HackerScouts/hackerling-circuit/docs/designing_notes.odt

Designing Hackerling circuit

Timers

There are several components that need timers:

Servos:

Servos work by sending a PWM (Pulse width modulated) signal. The period of this pulse is 50-60 Hz. The width of the pulse determines the position of the servo, on the range of: ~500us to 2000us. Assuming that the servo turns 180 degrees (although most just turn 90) and you want resolution of 1 degree, you will need resolution of ~8us.

http://www.servocity.com/html/180o_rotation_information.html

IR receiver, transmitter:

The IR receiver is tuned to a 38Khz carrier wave. According to the data sheet, the width of the data pulses should be at least 200us, and the output of the receiver has a pulse width of 400-1200us. We will have to slow the data rate to whatever the output rate of the receiver ends up being. This is an easy signal; as long as we configure the LEDs to pulse at 38Khz, we can check the input of the reciever each cycle, and also decide whether to set the “set” the data bit. A 600 us pulse is ~26 cycles of the 38Khz signal; we can send bit lengths from 8 to 40 cycles.

Speaker:

The speaker is a bit tricky. It involves looking up some info about sound.

We can hear sound from ~10Hz to ~5Khz. We perceive sound on a logarithmic scale, and sounds that are a factor of 2 apart sound very similar to us. For that reason, we group sounds within one order of 2 (for example from 220Hz to 440Hz) into what is known as an octave. We then subdivide each octave into smaller parts: the Chromatic scale defines the 12 notes we are usually familiar with (A,A#,B,C...etc) and the most commonly used pitch scale, A440 defines “the A above middle C” to have a frequency of 440Hz, and for each note to be spaced at an equal interval (on the logarithmic scale). Thus we can get all the frequencies of the notes by starting at 440 and multiplying by 2^(1/12). This gives us the following table:

Of course, since we are dealing with a logarithmic scale, which will give us irrational numbers and using subdivisions of a 16Mhz clock signal, we cannot hit all the notes exactly. So how close is good enough?

Well, according to this website, we cannot tell a difference of 5 cents, a cent being a 100th subdivision between adjacent notes, again equally subdivided on a logarithmic scale) so we only need to get w/in ~5 cents of the note.

The other problem with playing sound is that, since the scale changes so much, using one prescaler is not going to be very helpful; you will have a large amount of resolution in a few octaves, but very little in others. Even in 1 octave, some notes will be harder to achieve than others. The solution to this is to change the prescaler for different octaves. Usually atmel timers have a prescaler that changes by a power of 4, but on the atmega328, which we will be using, the timer2 has the following prescales:

1,8,32,64,128,256,1024 – 4 prescales being a power of two apart, perfect for octaves!

Here is a big table that shows the error of trying to play each note using different prescale values:

(http://en.wikipedia.org/wiki/Octave)

(http://en.wikipedia.org/wiki/Octave)

(http://en.wikipedia.org/wiki/Octave)

(http://en.wikipedia.org/wiki/Octave)

(http://en.wikipedia.org/wiki/Octave)

(http://en.wikipedia.org/wiki/Octave)

(http://en.wikipedia.org/wiki/Octave)

(http://en.wikipedia.org/wiki/Octave)

(http://en.wikipedia.org/wiki/Octave)

(http://en.wikipedia.org/wiki/Octave)

(http://en.wikipedia.org/wiki/Octave)

(http://en.wikipedia.org/wiki/Octave)

(http://en.wikipedia.org/wiki/Octave)

(http://en.wikipedia.org/wiki/Octave)

(http://en.wikipedia.org/wiki/Octave)

(http://en.wikipedia.org/wiki/Octave)

(http://en.wikipedia.org/wiki/Octave)

(http://en.wikipedia.org/wiki/Octave)

(http://en.wikipedia.org/wiki/Octave)

(http://en.wikipedia.org/wiki/Octave)

(http://en.wikipedia.org/wiki/Octave)

(http://en.wikipedia.org/wiki/Octave)

(http://en.wikipedia.org/wiki/Octave)

(http://en.wikipedia.org/wiki/Octave)

(http://en.wikipedia.org/wiki/Octave)

(http://en.wikipedia.org/wiki/Octave)

(http://en.wikipedia.org/wiki/Octave)

(http://en.wikipedia.org/wiki/Octave)

(http://en.wikipedia.org/wiki/Octave)

(http://en.wikipedia.org/wiki/Octave)

(http://en.wikipedia.org/wiki/Octave)

(http://en.wikipedia.org/wiki/Octave)

(http://en.wikipedia.org/wiki/Octave)

(http://en.wikipedia.org/wiki/Octave)

(http://en.wikipedia.org/wiki/Octave)

(http://en.wikipedia.org/wiki/Octave)

(http://en.wikipedia.org/wiki/Octave)

(http://en.wikipedia.org/wiki/Octave)

(http://en.wikipedia.org/wiki/Octave)

(http://en.wikipedia.org/wiki/Octave)

(http://en.wikipedia.org/wiki/Octave)

(http://en.wikipedia.org/wiki/Octave)

(http://en.wikipedia.org/wiki/Octave)

(http://en.wikipedia.org/wiki/Octave)

(http://en.wikipedia.org/wiki/Octave)

(http://en.wikipedia.org/wiki/Octave)

(http://en.wikipedia.org/wiki/Octave)

You notice that there is a distinct pattern that shows up – the prescales are logarithmic and so are the notes, so to computation comes out the same for when you increment the octave and double prescale value.

I grayed out certain parts of the table – those parts correspond to frequencies that are too low – meaning we would have to wait for a timer overflow, then increment a counter, and possibly change the compare interrupt at least once per period. This would be acceptable and allow greater accuracy if we were making something that only played sounds, but this is a multi-use device, and we want to have as little code executed by the main processor as possible. Therefore, we will not use the greyed areas.

Using the rest of the table, it is clear that you want to use as low a prescale as possible – lower prescales mean higher frequency, which means finer resolution. In the first octave the prescale can achieve, there is only one frequency that is over 5 cents off – G# (5.67 cents off), which isn't used much anyway. Down at 92Hz, you also have larger errors since the prescaler jumps by two, but this is pretty low, so we'll accept it.

(http://en.wikipedia.org/wiki/Octave)

http://en.wikipedia.org/wiki/Octave

http://en.wikipedia.org/wiki/A440_%28pitch_standard%29

http://www.aqdi.com/tuner.htm

We have 3 timers and 3 oscillating devices – perfect! (although certain functions of the arduino seem like they want to use a timer...)

Looking at pre-existing code, it seems like the servo is always run off of the

coding IR reciever

Found code at:

http://playground.arduino.cc/Code/InfraredReceivers for plotting outputs

plotted the output of the LED remote:

ON: 0x00 0xF7 0x20 0xDC (last two zeros not received though)

Red: 0x00 0xF7 0xC0 0x3C

Green:

Used this scrip, which gave the output:

tail -132 stream7 | awk 'BEGIN{last=0;s=0}{x=$1-last;b=0;if(x>1000) b=1;if(x>0 && $2==1)s*=2;if(x>0 && $2==1)s+=b; if(x>0 && $2==1)printf("%d %d %x\n",$1,x,s); last=$1}'

14492 476 0

15616 560 0

16712 480 0

17832 480 0

18956 564 0

20052 484 0

21172 480 0

22288 556 0

24508 1604 1

26728 1660 3

28972 1604 7

31184 1600 f

32308 564 1e

34520 1600 3d

36740 1660 7b

38980 1600 f7

41200 1604 1ef

42320 560 3de

44536 1604 7bd

45656 560 f7a

46752 480 1ef4

47880 488 3de8

48996 564 7bd0

50092 488 f7a0

51212 484 1ef40

53432 1664 3de81

54552 484 7bd02

56768 1660 f7a05

59008 1604 1ef40b

61224 1604 3de817

63444 1660 7bd02f

65688 1604

the time high is:

~1660 for 1

480 or 560 for 0

the low time is ~640

this time is in microseconds

so the output is 0xf7a05f

The frequency we are oscillating at is: 37914.691943128Hz which is 26.375 us

if our divisions are 1000us and 3500 us, this works out to:

1000us → 37.9 cycles → 38 cycles

3500us → 132.7 cycles → 133 cycles
