HackerScouts/hackerling-circuit/docs/Hackerling_Circuit_BOM.xls

Sheet: v1.3
Part number | qnty
k1 | 1 | 40 pin straight header | S1012EC-40-ND | CONN HEADER .100" SNGL STR 40POS | digikey
k2 | 2 | 330 Ohm resistor array | CSC330N-ND | RES ARRAY 330 OHM 7 RES 8-SIP | digikey
k3 | 1 | Green 5MM LED | 100QBK-ND | RES 100 OHM 1/4W 5% CARBON FILM | digikey
k4 | 1 | Speaker | 254-EMB15-RO | MINI TONE TRANSDUCER | Mouser
k5 | 1 | 100 Ohm Resistor | 100QBK-ND | RES 100 OHM 1/4W 5% CARBON FILM | digikey
k6 | 1 | B-12 Switch | 633-B12JH |  | Mouser
k7 | 1 | 8 pin io expander | MCP23008-E/P-ND | IC I/O EXPANDER I2C 8B 18DIP | digikey
k8 | 1 | 16 pin io expander | MCP23017-E/SP-ND | IC I/O EXPANDER I2C 16B 28SDIP | digikey
k9 | 1 | Bargraph LED Array | 604-DC10GWA |  | Mouser
k10 | 2 | 100 Ohm resistor array | 4608X-2-101LF-ND | RES ARRAY 100 OHM 4 RES 8SIP | digikey
k11 | 1 | Dip Switch | CT2094MS-ND | SWITCH RAISED ACTUATOR 4 SEC | digikey
k12 | 4 | 4x Buttons | SW413-ND | SWITCH TACTILE SPST-NO 0.05A 24V | digikey
k13 | 1 | Red cap | SW260-ND | KEYCAP 12MM SQ RED FITS 12MM | digikey
k14 | 1 | Orange cap | SW956-ND | KEYCAP 12MM SQ ORANGE FITS | digikey
k15 | 1 | Green Cap | SW957-ND | KEYCAP 12MM GRN FITS 12MM | digikey
k16 | 1 | Blue Cap | SW258-ND | KEYCAP 12MM SQ BLUE FITS 12MM | digikey
k17 | 1 | 47 Ohm resistor | 47QBK-ND | RES 47 OHM 1/4W 5% CARBON FILM | digikey
k18 | 1 | 10 uF cap | 445-2863-ND | CAP CER 10UF 6.3V 10% RADIAL | digikey
k19 | 1 | IR photo detector | 425-2501-ND | RECEIVER IR REM CTRL 5V 38KHZ | digikey
k20 | 2 | IR LED | 475-1200-ND | EMITTER IR 850NM 5MM RADIAL | digikey
k21 | 1 | 6 pin right angle header | S1112EC-40-ND | CONN HEADER .100" SNGL R/A 40POS | digikey
k22 | 1 | 502kOhm resistor | 412KXBK-ND | RES 412K OHM 1/4W 1% METAL FILM | digikey
k23 | 1 | 100 Kohm thermistor | BC2424-ND | THERMISTOR NTC 330K 5% RADIAL | digikey
k24 | 1 | 10k pot | PTV09A-4225F-B103-ND | POT 10K OHM 9MM SQ .05W CARB | digikey
k25 | 1 | Pot cap | 450-2034-GRX | KNOB FOR 1/4" SHAFT | Mouser
k26 | 1 | 100 Ohm Pot | 3306K-103-ND | TRIMMER 10K OHM 0.2W PC PIN | digikey
k27 | 1 | 16x2 char LCD | 668-NC-S16205DFYSAY |  | Mouser
a1 | 1 | Accelerometer | 841-MMA8452QR1 | IC ACCELEROMETER 3AXIS 16QFN | Mouser
a2 | 2 | 470 ohm resistor | RMCF0603JT470RCT-ND | RES 470 OHM 1/10W 5% 0603 | digikey
a3 | 1 | 200K resistor | 311-200KGRCT-ND | RES 200K OHM 1/10W 5% 0603 SMD | digikey
a4 | 1 | I2c Level shifter | 296-17988-1-ND | IC VOLT LEVEL TRANSLATOR 8-VSSOP | digikey
a5 | 1 | 4.7 uF Cap | 399-3482-1-ND | CAP CER 4.7UF 6.3V 10% X5R 0603 | digikey
a6 | 2 | 4k7 resistor | CR0603-JW-472ELFCT-ND | RES 4.7K OHM 1/10W 5% 0603 SMD | digikey
a7 | 1 | .1 uF Cap | 311-1341-1-ND | CAP CER 0.1UF 25V 10% X7R 0603 | digikey
a8 | 1 | 1 uF cap | 311-1372-1-ND | CAP CER 1UF 16V Y5V 0603 | digikey
a9 | 1 | 3.3V power supply | TC1016-3.3VCTCT-ND | IC REG LDO 3.3V 80MA SOT23-5 | digikey

Sheet: v1.2
Index | Quantity | Part Number | Description |  | Customer Reference | Quantity needed | Unit Price USD
1 | 30 | CT2094MS-ND | SWITCH RAISED ACTUATOR 4 SEC |  | SW1 | 1 | 0.683 | 0.683
2 | 30 | 445-2863-ND | CAP CER 10UF 6.3V 10% RADIAL | FOR IR RECIEVER | C4 | 1 | 0.328 | 0.328
3 | 25 | 425-2501-ND | RECEIVER IR REM CTRL 5V 38KHZ | FOR IR RECIEVER | IR1 | 1 | 0.768 | 0.768
4 | 30 | 3306K-103-ND | TRIMMER 10K OHM 0.2W PC PIN |  | U8 | 1 | 0.3456 | 0.3456
5 | 30 | 311-1355-1-ND | CAP CER 10UF 10V Y5V 0805 | Optional (to be removed) | C5 | 1 | 0.0824 | 0.0824
6 | 100 | 47QBK-ND | RES 47 OHM 1/4W 5% CARBON FILM | FOR IR RECIEVER | R6 | 1 | 0.0242 | 0.0242
7 | 100 | 311-47ARCT-ND | RES 47 OHM 1/8W 5% 0805 SMD | Optional (to be removed) | R7 | 1 | 0.0077 | 0.0077
8 | 120 | SW413-ND | SWITCH TACTILE SPST-NO 0.05A 24V |  | B1,B2,B3,B4 | 4 | 0.4253 | 1.7012
9 | 100 | 311-1372-1-ND | CAP CER 1UF 16V Y5V 0603 |  | C1 | 1 | 0.0186 | 0.0186
10 | 50 | 399-3482-1-ND | CAP CER 4.7UF 6.3V 10% X5R 0603 |  | C3 | 1 | 0.0518 | 0.0518
11 | 25 | MCP23008-E/P-ND | IC I/O EXPANDER I2C 8B 18DIP |  | IC2 | 1 | 0.85 | 0.85
12 | 100 | 475-1200-ND | EMITTER IR 850NM 5MM RADIAL |  | LED1,LED2,LED3 | 3 | 0.3879 | 1.1637
13 | 60 | CSC330N-ND | RES ARRAY 330 OHM 7 RES 8-SIP |  | RN3,RN4 | 2 | 0.231 | 0.462
14 | 30 | MMA8452QT-ND | IC ACCELEROMETER 3AXIS 16QFN |  | U1 | 1.5 | 1.168 | 1.752
15 | 100 | 296-17988-1-ND | IC VOLT LEVEL TRANSLATOR 8-VSSOP |  | U5 | 1 | 0.3159 | 0.3159
16 | 20 | S1012EC-40-ND | CONN HEADER .100" SNGL STR 40POS |  | STRAIGHT HEADERS | 2 | 0.459 | 0.918
17 | 5 | S1112EC-40-ND | CONN HEADER .100" SNGL R/A 40POS |  | RIGHT ANGLE HEADER | 0.1 | 0.64 | 0.064
18 | 30 | BC2424-ND | THERMISTOR NTC 330K 5% RADIAL |  | R1 | 1 | 0.264 | 0.264
19 | 100 | 412KXBK-ND | RES 412K OHM 1/4W 1% METAL FILM |  | R2 | 1 | 0.0315 | 0.0315
20 | 1 | EG2448-ND | SWITCH TOGGLE SPDT .4VA RT ANG |  | SW2 ALT | 1 | 3.22 | 3.22
21 | 30 | TC1016-3.3VCTCT-ND | IC REG LDO 3.3V 80MA SOT23-5 |  | IC3 | 1 | 0.3 | 0.3
 |  |  |  |  |  |  |  | 0
20 |  | LCD-226 | LCD screen |  |  | 1 | 6.00 | 6 | allelectronics
20 |  | BG-10G | bargraph |  |  | 1 | 1.25 | 1.25 | allelectronics
20 |  | KNB-124 | knob for pot |  |  | 1 | 0.65 | 0.65 | allelectronics
20 |  | PE-52 | buzzer |  |  | 1 | 0.50 | 0.5 | allelectronics
 |  |  | Board |  |  | 1 | 10 | 10
 |  | 652-PTV09A-4225FB102 |  |  |  | 1 | 0.62 | 0.62
 |  | 633-B12JH |  |  |  | 1 | 3.46 | 3.46
 |  | 579-MCP23017-E/SP |  |  |  | 1 | 1 | 1
 |  |  | arduino uno |  |  |  |  | 26.95
 |  |  |  |  |  |  |  | 63.7816

Sheet: v1.1
board part ID | My part ID | description | value | size | qnty used | price |  | Use notes | Retail ID | Retailor | Manufacturer's id
 | MTS-86RT | DPDT ON-ON MINI-TOGGLE SWITCH |  |  |  | 1.25 |  | maybe too big? | MTS-86RT | AllElectronics
R1 | TNR-103 | 10K OHM NTC THERMISTOR |  |  | 1 | 0.65 |  |  | TNR-103 | AllElectronics
 | PE-52 | MINI TONE TRANSDUCER |  |  |  | 0.5 |  |  | PE-52 | AllElectronics
SG1 | PE-38 | MINI TONE TRANSDUCER |  | 0.82" DIA. X 0.15" | 1 | 0.334 |  |  | PE-38 | AllElectronics
 | PB-214 | JUMBO PUSHBUTTON, GREEN |  |  | 0 | 3.75 |  |  | PB-214 | AllElectronics
U2 | LCD-226 | 16 X 2 LCD W/ LED BACKLIGHT |  |  |  | 6 |  |  | LCD-226 | AllElectronics
 | LCD-2161 | 16 X 1 LCD W/ LED BACKLIGHT |  |  |  | 3 |  |  | LCD-2161 | AllElectronics
 | LCD-8002 | 8 CHARACTER X 2 LINE LCD |  |  |  | 3.25 |  |  | LCD-8002 | AllElectronics
 | BG-10G | 10 SEGMENT BARGRAPH, GREEN |  |  |  | 1.5 |  |  | BG-10G | AllElectronics
 | KNB-124 | KNOB FOR 1/4" SHAFT |  |  |  | 0.75 |  |  | KNB-124 | AllElectronics
 | LPC-10K | 10K LIN. POT W/CTR DETENT, PC MT |  |  |  | 0.25 |  |  | LPC-10K | AllElectronics
 | DWS-4S | 4-POLE DIP SWITCH, LOW PROFILE |  |  |  | 1 | digikey | CT2094MS-ND | DWS-4S | AllElectronics
 | CSC330N-ND | RES ARRAY 330 OHM 7 RES 8-SIP |  |  | 2 | 0.49 |  |  | CSC330N-ND | Digikey |  | RN1, RN2 | $1.96
 | 296-17988-1-ND | IC VOLT LEVEL TRANSLATOR 8-VSSOP |  |  | 1 | 0.96 |  |  | 296-17988-1-ND | Digikey |  | I2C TRANSLATOR | $3.84
 | MMA8452QT-ND | IC ACCELEROMETER 3AXIS 16QFN |  |  | 1 | 1.31 |  |  | MMA8452QT-ND | Digikey |  | ACCELEROMETER | $5.24
 | TC1016-3.0VCTCT-ND | IC REG LDO 3V 80MA SOT23-5 |  |  | 0 | 0.43 |  |  | TC1016-3.0VCTCT-ND | Digikey |  | 3.3V REG | $1.72
 | 1219-1083-1-ND | IC REG LDO 3V SOT23-5 |  |  | 1 | 0.4 |  |  | 1219-1083-1-ND | Digikey |  | 3V REG | $1.60
 | MCP23008-E/P-ND | IC I/O EXPANDER I2C 8B 18DIP |  |  | 1 | 1.22 |  |  | MCP23008-E/P-ND | Digikey |  |  | $4.88
 | 1050-1024-ND | ARDUINO UNO BOARD REV3 |  |  | 1 | 26.39 |  |  | 1050-1024-ND | Digikey |  |  | $52.78
 | MCP23017-E/SP-ND | IC I/O EXPANDER I2C 16B 28SDIP |  |  | 1 | 1.44 |  |  | MCP23017-E/SP-ND | Digikey |  |  | $5.76
 | SW414-ND | SWITCH TACTILE SPST-NO 0.05A 24V |  |  | 4 | 0.5124 |  |  | SW414-ND | Digikey |  |  | $12.81
 | SW957-ND | KEYCAP 12MM GRN FITS 12MM |  |  | 1 | 0.279 |  |  | SW957-ND | Digikey |  |  | $2.79
 | SW956-ND | KEYCAP 12MM SQ ORANGE FITS |  |  | 1 | 0.279 |  |  | SW956-ND | Digikey |  |  | $2.79
 | SW260-ND | KEYCAP 12MM SQ RED FITS 12MM |  |  | 1 | 0.279 |  |  | SW260-ND | Digikey |  |  | $2.79
 | SW258-ND | KEYCAP 12MM SQ BLUE FITS 12MM |  |  | 1 | 0.279 |  |  | SW258-ND | Digikey |  |  | $2.79
 | 475-1200-ND | EMITTER IR 850NM 5MM RADIAL |  |  |  | 0.428 |  |  | 475-1200-ND | Digikey |  |  | $4.28
 | EG4912-ND | SWITCH TOGGLE SPDT .4VA R/A |  |  | 1 | 2.99 |  |  | EG4912-ND | Digikey |  |  | $5.98
 | B13EH-ND | SW TOGGLE SPDT .4VA RA BRKT ESD |  |  | 0 | 4.2 |  |  | B13EH-ND | Digikey |  |  | $8.40
 | 425-2501-ND | RECEIVER IR REM CTRL 5V 38KHZ |  |  | 1 | 0.96 |  |  | 425-2501-ND | Digikey |  |  | $3.84
 | 311-1372-1-ND | CAP CER 1UF 16V Y5V 0603 |  |  |  | 0.041 |  |  | 311-1372-1-ND | Digikey |  |  | $0.41
 | 399-3482-1-ND | CAP CER 4.7UF 6.3V 10% X5R 0603 |  |  |  | 0.09 |  |  | 399-3482-1-ND | Digikey |  |  | $0.90
 | 311-200KGRCT-ND | RES 200K OHM 1/10W 5% 0603 SMD |  |  | 1 | 0.0048 |  |  | 311-200KGRCT-ND | Digikey |  |  | $0.48
R3,R4 | CR0603-JW-472ELFCT-ND | RES 4.7K OHM 1/10W 5% 0603 SMD |  |  |  | 0.0044 |  |  | CR0603-JW-472ELFCT-ND | Digikey |  |  | $0.44
 | 311-1341-1-ND | CAP CER 0.1UF 25V 10% X7R 0603 |  |  |  | 0.01 |  |  | 311-1341-1-ND | Digikey |  |  | $1.00
 |  |  |  |  |  | 65.2306

Sheet: Sheet2
therm | 1 | 2 | 3 | 4 | 5 | 6 | 7 | 8 | 9 | 10 | 11 | 12 | 13 | 14 | 15 | 16 | 17 | 18 | 19 | 20 | 21 | 22
1 | 0.500 | 0.667 | 0.750 | 0.800 | 0.833 | 0.857 | 0.875 | 0.889 | 0.900 | 0.909 | 0.917 | 0.923 | 0.929 | 0.933 | 0.938 | 0.941 | 0.944 | 0.947 | 0.950 | 0.952 | 0.955 | 0.957
2 | 0.333 | 0.500 | 0.600 | 0.667 | 0.714 | 0.750 | 0.778 | 0.800 | 0.818 | 0.833 | 0.846 | 0.857 | 0.867 | 0.875 | 0.882 | 0.889 | 0.895 | 0.900 | 0.905 | 0.909 | 0.913 | 0.917
3 | 0.250 | 0.400 | 0.500 | 0.571 | 0.625 | 0.667 | 0.700 | 0.727 | 0.750 | 0.769 | 0.786 | 0.800 | 0.812 | 0.824 | 0.833 | 0.842 | 0.850 | 0.857 | 0.864 | 0.870 | 0.875 | 0.880
4 | 0.200 | 0.333 | 0.429 | 0.500 | 0.556 | 0.600 | 0.636 | 0.667 | 0.692 | 0.714 | 0.733 | 0.750 | 0.765 | 0.778 | 0.789 | 0.800 | 0.810 | 0.818 | 0.826 | 0.833 | 0.840 | 0.846
5 | 0.167 | 0.286 | 0.375 | 0.444 | 0.500 | 0.545 | 0.583 | 0.615 | 0.643 | 0.667 | 0.688 | 0.706 | 0.722 | 0.737 | 0.750 | 0.762 | 0.773 | 0.783 | 0.792 | 0.800 | 0.808 | 0.815
6 | 0.143 | 0.250 | 0.333 | 0.400 | 0.455 | 0.500 | 0.538 | 0.571 | 0.600 | 0.625 | 0.647 | 0.667 | 0.684 | 0.700 | 0.714 | 0.727 | 0.739 | 0.750 | 0.760 | 0.769 | 0.778 | 0.786
7 | 0.125 | 0.222 | 0.300 | 0.364 | 0.417 | 0.462 | 0.500 | 0.533 | 0.562 | 0.588 | 0.611 | 0.632 | 0.650 | 0.667 | 0.682 | 0.696 | 0.708 | 0.720 | 0.731 | 0.741 | 0.750 | 0.759
8 | 0.111 | 0.200 | 0.273 | 0.333 | 0.385 | 0.429 | 0.467 | 0.500 | 0.529 | 0.556 | 0.579 | 0.600 | 0.619 | 0.636 | 0.652 | 0.667 | 0.680 | 0.692 | 0.704 | 0.714 | 0.724 | 0.733
9 | 0.100 | 0.182 | 0.250 | 0.308 | 0.357 | 0.400 | 0.438 | 0.471 | 0.500 | 0.526 | 0.550 | 0.571 | 0.591 | 0.609 | 0.625 | 0.640 | 0.654 | 0.667 | 0.679 | 0.690 | 0.700 | 0.710
10 | 0.091 | 0.167 | 0.231 | 0.286 | 0.333 | 0.375 | 0.412 | 0.444 | 0.474 | 0.500 | 0.524 | 0.545 | 0.565 | 0.583 | 0.600 | 0.615 | 0.630 | 0.643 | 0.655 | 0.667 | 0.677 | 0.688
 | 0.2424242424 | 0.3333333333 | 0.3692307692 | 0.380952381 | 0.380952381 | 0.375 | 0.3660130719 | 0.3555555556 | 0.3444976077 | 0.3333333333 | 0.3223443223 | 0.3116883117 | 0.3014492754 | 0.2916666667 | 0.2823529412 | 0.2735042735 | 0.2651072125 | 0.2571428571 | 0.249589491 | 0.2424242424 | 0.2356241234 | 0.2291666667
 | 0.05194805195 | 0.08333333333 | 0.1025641026 | 0.1142857143 | 0.1212121212 | 0.125 | 0.1266968326 | 0.126984127 | 0.1263157895 | 0.125 | 0.1232492997 | 0.1212121212 | 0.118993135 | 0.1166666667 | 0.1142857143 | 0.1118881119 | 0.1095008052 | 0.1071428571 | 0.1048275862 | 0.1025641026 | 0.1003584229 | 0.09821428571

Sheet: Sheet3
board part ID | My part ID | description | value | size | qnty used | qnty have | price | Use notes | Retail ID | Retailor | Manufacturer's id
 | MTS-86RT | DPDT ON-ON MINI-TOGGLE SWITCH |  |  |  | 2 | 1.25 | maybe too big? | MTS-86RT | AllElectronics
R1 | TNR-103 | 10K OHM NTC THERMISTOR |  |  | 1 | 3 | 0.65 |  | TNR-103 | AllElectronics
SG1 | PE-38 | MINI TONE TRANSDUCER |  | 0.82" DIA. X 0.15" | 1 | 3 | 0.334 |  | PE-38 | AllElectronics
 | PB-214 | JUMBO PUSHBUTTON, GREEN |  |  | 0 | 1 | 3.75 |  | PB-214 | AllElectronics
 | LCD-2161 | 16 X 1 LCD W/ LED BACKLIGHT |  |  |  | 2 | 3 |  | LCD-2161 | AllElectronics
 | LCD-8002 | 8 CHARACTER X 2 LINE LCD |  |  |  | 2 | 3.25 |  | LCD-8002 | AllElectronics
 |  |  |  |  |  |  |  |  |  |  |  | I2C TRANSLATOR | $3.84
 | TC1016-3.0VCTCT-ND | IC REG LDO 3V 80MA SOT23-5 |  |  | 0 | 4 | 0.43 |  | TC1016-3.0VCTCT-ND | Digikey |  | 3.3V REG | $1.72
 | 1219-1083-1-ND | IC REG LDO 3V SOT23-5 |  |  | 1 | 4 | 0.4 |  | 1219-1083-1-ND | Digikey |  | 3V REG | $1.60
 | EG4912-ND | SWITCH TOGGLE SPDT .4VA R/A |  |  | 1 | 2 | 2.99 |  | EG4912-ND | Digikey |  |  | $5.98
 | B13EH-ND | SW TOGGLE SPDT .4VA RA BRKT ESD |  |  | 0 | 2 | 4.2 |  | B13EH-ND | Digikey |  |  | $8.40
 | SW957-ND | KEYCAP 12MM GRN FITS 12MM |  |  | 1 | 10 | 0.279 |  | SW957-ND | Digikey |  |  | $2.79
 | SW956-ND | KEYCAP 12MM SQ ORANGE FITS |  |  | 1 | 10 | 0.279 |  | SW956-ND | Digikey |  |  | $2.79
 | SW260-ND | KEYCAP 12MM SQ RED FITS 12MM |  |  | 1 | 10 | 0.279 |  | SW260-ND | Digikey |  |  | $2.79
 | SW258-ND | KEYCAP 12MM SQ BLUE FITS 12MM |  |  | 1 | 10 | 0.279 |  | SW258-ND | Digikey |  |  | $2.79

Sheet: Sheet4
 |  |  |  |  | qnty | ordered
B1 |  | SWITCH_BCF-4000 | SWITCH_B3F-4000 | hackerscouts | 120 | 2013-01-02 | SW414-ND | SWITCH TACTILE SPST-NO 0.05A 24V |  |  |  | 0.5124 |  |  | SW414-ND | Digikey
B2 |  | SWITCH_BCF-4000 | SWITCH_B3F-4000 | hackerscouts | 120 | 2013-01-02 | SW414-ND | SWITCH TACTILE SPST-NO 0.05A 24V |  |  |  | 0.5124 |  |  | SW414-ND | Digikey
B3 |  | SWITCH_BCF-4000 | SWITCH_B3F-4000 | hackerscouts | 120 | 2013-01-02 | SW414-ND | SWITCH TACTILE SPST-NO 0.05A 24V |  |  |  | 0.5124 |  |  | SW414-ND | Digikey
B4 |  | SWITCH_BCF-4000 | SWITCH_B3F-4000 | hackerscouts | 120 | 2013-01-02 | SW414-ND | SWITCH TACTILE SPST-NO 0.05A 24V |  |  |  | 0.5124 |  |  | SW414-ND | Digikey
C1 | 1uF | C-USC0603K | C0603K | resistor | 100 | 2013-01-02 | 311-1372-1-ND | CAP CER 1UF 16V Y5V 0603 |  |  | 10 | 0.041 |  |  | 311-1372-1-ND | Digikey
C2 | 0.1uF | C-USC0603K | C0603K | resistor | 100 | 2012-11-30 | 311-1341-1-ND | CAP CER 0.1UF 25V 10% X7R 0603 |  |  | 100 | 0.01 |  |  | 311-1341-1-ND | Digikey
C3 | 4.7uF | C-USC0603K | C0603K | resistor | 50 | 2013-01-02 | 399-3482-1-ND | CAP CER 4.7UF 6.3V 10% X5R 0603 |  |  | 10 | 0.09 |  |  | 399-3482-1-ND | Digikey
C4 | 10uF | C-US050-050X075 | C050-050X075 | rcl | 30 | 2013-01-02 | 445-2863-ND (http://www.digikey.com/scripts/DKSearch/dksus.dll?Detail&itemSeq=123546165&uq=634926983742302205) | CAP CER 10UF 6.3V 10% RADIAL
C5 | 10uF | C-USC0805K | C0805K | resistor | 30 | 2013-01-02 | 311-1355-1-ND (http://www.digikey.com/scripts/DKSearch/dksus.dll?Detail&itemSeq=124219124&uq=634926995471126111) | CAP CER 10UF 10V Y5V 0805
DZ1 | LB10 | LB10 | LB10 | led | 20 | 2012-12-06 | BG-10G | 10 SEGMENT BARGRAPH, GREEN |  |  | 4 | 1.5 |  |  | BG-10G
IC1 | MCP23017SP | MCP23017SP | DIL28-3 | adafruit | 30 | 2013-01-02 | MCP23017-E/SP-ND | IC I/O EXPANDER I2C 16B 28SDIP | mouser | 1 | 4 | 1.44 |  |  | MCP23017-E/SP-ND | Digikey
IC2 | MCP2300X/P | MCP2300X/P | DIL18 | adafruit | 25 | 2013-01-02 | MCP23008-E/P-ND | IC I/O EXPANDER I2C 8B 18DIP |  | 1 | 4 | 1.22 |  |  | MCP23008-E/P-ND | Digikey
IC3 | MIC5219BM5 | MIC5219BM5 | SOT23-5 | v-reg-micrel | 30 | 2013-01-02 | TC1016-3.3VCTCT-ND (http://www.digikey.com/scripts/DKSearch/dksus.dll?Detail&itemSeq=124254332&uq=634927446236049921) | IC REG LDO 3.3V 80MA SOT23-5
IR1 | PNA460XM | PNA460XM | PNA460XM | adafruit | 25 | 2013-01-02 | 425-2501-ND | RECEIVER IR REM CTRL 5V 38KHZ |  | 1 | 4 | 0.96 |  |  | 425-2501-ND | Digikey
JP1 |  | M02LOCK | 1X02_LOCK | SparkFun |  | 2013-01-02 | S1012EC-40-ND (http://www.digikey.com/scripts/DKSearch/dksus.dll?Detail&itemSeq=124244704&uq=634927353556944550) | straight header 2x
JP2 |  | M02LOCK | 1X02_LOCK | SparkFun |  | 2013-01-02 | S1012EC-40-ND (http://www.digikey.com/scripts/DKSearch/dksus.dll?Detail&itemSeq=124244704&uq=634927353556944550) | straight header 2x
LED1 |  | LED5MM | LED5MM | SparkFun | 100 | 2013-01-02 | 475-1200-ND | EMITTER IR 850NM 5MM RADIAL |  |  | 10 | 0.428 |  |  | 475-1200-ND | Digikey
LED2 |  | LED5MM | LED5MM | SparkFun | 100 | 2013-01-02 | 475-1200-ND | EMITTER IR 850NM 5MM RADIAL |  |  | 10 | 0.428 |  |  | 475-1200-ND | Digikey
LED3 |  | LED5MM | LED5MM | SparkFun | 100 | 2013-01-02 | 475-1200-ND | EMITTER IR 850NM 5MM RADIAL |  |  | 10 | 0.428 |  |  | 475-1200-ND | Digikey
R1 | THERMISTOR-5 | THERMISTOR-5 | R-5 | varistor | 30 | 2013-01-02 | BC2424-ND (http://www.digikey.com/scripts/DKSearch/dksus.dll?Detail&itemSeq=124251169&uq=634927409292604193) | THERMISTOR NTC 330K 5% RADIAL
R2 |  | R-EU_0204/7 | 0204/7 | resistor | 100 | 2013-01-02 | 412KXBK-ND (http://www.digikey.com/scripts/DKSearch/dksus.dll?Detail&itemSeq=124251684&uq=634927409292604193) | RES 412K OHM 1/4W 1% METAL FILM
R3 | 4k7 | RESISTOR0603-RES | 0603-RES | SparkFun | 100 | 2012-11-30 | CR0603-JW-472ELFCT-ND | RES 4.7K OHM 1/10W 5% 0603 SMD |  |  | 100 | 0.0044 |  |  | CR0603-JW-472ELFCT-ND | Digikey
R4 | 4k7 | RESISTOR0603-RES | 0603-RES | SparkFun | 100 | 2012-11-30 | CR0603-JW-472ELFCT-ND | RES 4.7K OHM 1/10W 5% 0603 SMD |  |  | 100 | 0.0044 |  |  | CR0603-JW-472ELFCT-ND | Digikey
R5 | 200K | RESISTOR0603-RES | 0603-RES | SparkFun | 100 | 2012-11-30 | 311-200KGRCT-ND | RES 200K OHM 1/10W 5% 0603 SMD |  | 1 | 100 | 0.0048 |  |  | 311-200KGRCT-ND | Digikey
R6 | 47 | R-US_0204/7 | 0204/7 | resistor | 100 | 2013-01-02 | 47QBK-ND (http://www.digikey.com/scripts/DKSearch/dksus.dll?Detail&itemSeq=124219190&uq=634926999547019698) | RES 47 OHM 1/4W 5% CARBON FILM
R7 | 47 | R-US_R0805 | R0805 | rcl | 100 | 2013-01-02 | 311-47ARCT-ND (http://www.digikey.com/scripts/DKSearch/dksus.dll?Detail&itemSeq=124219219&uq=634926999547019698) | RES 47 OHM 1/8W 5% 0805 SMD
RN3 |  | G07R | SIL8 | resistor-sil | 60 | 2013-01-02 | CSC330N-ND | RES ARRAY 330 OHM 7 RES 8-SIP |  | 2 | 4 | 0.49 |  |  | CSC330N-ND | Digikey
RN4 |  | G07R | SIL8 | resistor-sil | 60 | 2013-01-02 | CSC330N-ND | RES ARRAY 330 OHM 7 RES 8-SIP |  | 2 | 4 | 0.49 |  |  | CSC330N-ND | Digikey
SERVO1 |  | M03LOCK | 1X03_LOCK | SparkFun |  | 2013-01-02 | S1112EC-40-ND (http://www.digikey.com/scripts/DKSearch/dksus.dll?Detail&itemSeq=124245388&uq=634927353556944550) | right angle
SERVO2 |  | M03LOCK | 1X03_LOCK | SparkFun |  | 2013-01-02 | S1112EC-40-ND (http://www.digikey.com/scripts/DKSearch/dksus.dll?Detail&itemSeq=124245388&uq=634927353556944550) | right angle
SG1 | BUZZERNS | BUZZERNS | BUZZER-12MM-NS | SparkFun | 20 | 2012-12-06 | PE-52 | MINI TONE TRANSDUCER |  |  | 4 | 0.5 |  |  | PE-52 | AllElectronics
SW1 |  | SW_DIP-4 | EDG-04 | special | 30 | 2013-01-02 | DWS-4S | 4-POLE DIP SWITCH, LOW PROFILE |  |  | 3 | 1 | digikey | CT2094MS-ND | DWS-4S | AllElectronics | CT2094MS-ND (http://www.digikey.com/scripts/DKSearch/dksus.dll?Detail&itemSeq=123452126&uq=634926983742302205) | SWITCH RAISED ACTUATOR 4 SEC
SW2 | SWITCH_B13EH | SWITCH_B13EH | SWITCH_B13EH | hackerscouts | 25 | 2013-01-02 | B12JH | mouser
U4 | ACCELEROMETER | ACCELEROMETER | ACCELEROMETER | hackerscouts |  | 2013-01-02 | S1012EC-40-ND (http://www.digikey.com/scripts/DKSearch/dksus.dll?Detail&itemSeq=124244704&uq=634927353556944550) | straight header 6x
U6 | ACCELEROMETER | ACCELEROMETER | ACCELEROMETER | hackerscouts |  | 2013-01-02 |  | duplicate...
U8 | SML_POT | SML_POT | SML_POT | hackerscouts | 30 | 2013-01-02 | 3306K-103-ND (http://www.digikey.com/scripts/DKSearch/dksus.dll?Detail&itemSeq=124219018&uq=634926999547019698) | TRIMMER 10K OHM 0.2W PC PIN
U1 | MMA8452Q | MMA8452Q | QFN-16(5X3) | hackerscouts | 30 | 2013-01-02 | MMA8452QT-ND | IC ACCELEROMETER 3AXIS 16QFN |  | 1 | 4 | 1.31 |  |  | MMA8452QT-ND | Digikey
U2 | LCD_16X2 | LCD_16X2 | LCD_16X2 | hackerscouts | 20 | 2012-12-06 | LCD-226 | 16 X 2 LCD W/ LED BACKLIGHT |  |  | 1 | 6 |  |  | LCD-226 | AllElectronics
U3 | ARDUINOR3-BPLACE | ARDUINOR3-BPLACE | ARDUINOR3-BPLACE | adafruit |  | 2013-01-02 | S1012EC-40-ND (http://www.digikey.com/scripts/DKSearch/dksus.dll?Detail&itemSeq=124244704&uq=634927353556944550) | straight header 10,8,6,5x → 29x
U5 | PCA9306 | PCA9306 | VSSOP-8 | hackerscouts | 100 | 2013-01-02 | 296-17988-1-ND | IC VOLT LEVEL TRANSLATOR 8-VSSOP |  | 1 | 4 | 0.96 |  |  | 296-17988-1-ND | Digikey
U7 | POT | POT | ALS_POT | hackerscouts | 20 | 2012-12-06 | LPC-10K | 10K LIN. POT W/CTR DETENT, PC MT |  |  | 4 | 0.25 |  |  | LPC-10K | AllElectronics
 |  |  |  |  |  |  | 652-PTV09A-4225FB102 (http://www.mouser.com/Search/ProductDetail.aspx)
 |  |  |  |  | 20 | 2012-12-06 | KNB-124 | KNOB FOR 1/4" SHAFT |  |  | 1 | 0.75 |  |  | KNB-124 | AllElectronics
 |  |  |  |  | 20 | 2012-12-15 | 1050-1024-ND | ARDUINO UNO BOARD REV3 |  | 1 | 2 | 26.39 |  |  | 1050-1024-ND | Digikey

Sheet: Sheet5
 |  | Header prices
 |  |  | Price per part |  |  | price per pin
 | part | #pins | @10 | @25 | @100 | @10 | @25 | @100
 | S1012EC-40-ND | 40 | 0.459 | 0.459 | 0.378 | 0.011475 | 0.011475 | 0.009450
 | 952-2267-ND | 5 | 0.275 | 0.1952 | 0.1375 | 0.055000 | 0.039040 | 0.027500
 | 952-1843-ND | 10 | 0.383 | 0.286 | 0.22 | 0.038300 | 0.028600 | 0.022000
 | 952-1901-ND | 20 | 0.63 | 0.54 | 0.423 | 0.031500 | 0.027000 | 0.021150
 | A26509-40-ND | 40 | 1.703 | 1.703 | 1.402 | 0.042575 | 0.042575 | 0.035050
 | SAM1035-50-ND | 50 | 1.951 | 1.951 | 1.6065 | 0.039020 | 0.039020 | 0.032130
right angle | S1112EC-40-ND | 40 | 0.569 | 0.569 | 0.468 | 0.014225 | 0.014225 | 0.011700 |  |  |  |  |  |  | 13
 | 609-3408-ND | 20 | 0.946 | 0.8904 | 0.8162 | 0.047300 | 0.044520 | 0.040810 |  |  |  |  |  |  | 2.564949357
 |  |  |  |  |  | #DIV/0! | #DIV/0! | #DIV/0! |  |  |  |  |  |  | 13
 |  | 9.343093871
 |  | 2.234637447
 |  | 0.0005618902306
Beta values | 25 | 358.15
3977 | 10000 | 1070.309272 | Rref | A | B | C | D
 |  | 585.5158953 | 10000 | -14.6337 | 4557.725 | -98275 | -7522357
 |  |  |  |  |  |  |  |  |  | 0.01953125
 |  |  | Temps:
 |  |  | 25C | 85C | 100F | 32F |  | using10k | using 10k | dV/dT | bits/degree
Part # | Beta values | R25 | 298.15 | 358.15 | 316.483 | 273.15 |  | V100 | V32 |  |  |  |  | 273.15 | 277.15 | 281.15 | 285.15 | 289.15 | 293.15 | 297.15 | 301.15 | 305.15 | 309.15 | 313.15 | 317.15
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
 |  |  |  |  |  | 135801.148 | 1342074.16 | 500000 | 1.067952995 | 3.642834228 | 0.03786590049 | 1.938858192
 |  |  |  |  |  | 135801.148 | 1342074.16 | 510000 | 1.051416124 | 3.623165284 | 0.03781984059 | 1.936499774
