HackerScouts/hackerling-circuit/docs/frequency_calcs.ods

Sheet: Sheet1
R1 | 2000 | 2001
R2 | 900 | 10000
C1 | 0.00000001 | 0.000001
T1 | 0.000020097 | 0.008316693
T2 | 0.000006237 | 0.00693
F | 37973.7221842485 | 65.5879934095
duty | 0.2368421053 | 0.4545247943 | 5000
 |  | 2.885
 | -14.98 | 30.48

Sheet: Sheet2
Timer clocks, freq |  |  |  |  |  |  |  |  |  |  | sound freq | wavelength |  | 5 cents high | 5 cents low
 |  |  |  |  |  |  |  |  | 1 | C | 65.41 Hz | 15.29 ms
 | Timer 0 | Timer 1 | Timer 2 | Timer 2 |  |  |  |  | 1 | C# | 69.30 Hz | 14.43 ms | 858.11 us
bits | 8 | 16 | 8 | 8 |  |  |  |  | 1 | D | 73.42 Hz | 13.62 ms | 809.95 us
clock | 16. Mhz | 16000000 | 16000000 | 16000000 |  |  |  |  | 1 | D# | 77.78 Hz | 12.86 ms | 764.49 us
prescale | 64 | 8 | 128 | 64 |  |  |  |  | 1 | E | 82.41 Hz | 12.13 ms | 721.58 us |  |  |  |  |  |  |  |  |  |  | .5-2ms
freq_scaled | 250. Khz | 2000000 | 125000 | 250000 |  |  |  |  | 1 | F | 87.31 Hz | 11.45 ms | 681.08 us
max frequency | 125. Khz | 1000000 | 62500 | 125000 |  |  |  |  | 1 | F# | 92.50 Hz | 10.81 ms | 642.85 us |  |  |  |  |  | Component | #output | #input | Frequency | resolution
min freq | 488.28 Hz | 15.2587890625 | 244.140625 | 488.28125 |  |  |  |  | 1 | G | 98.00 Hz | 10.2 ms | 606.77 us |  |  |  |  |  | Servo | 2 | 0 | 500 Hz
min period/incriment | 8. us | 1000 ns | 16. us | 8. us |  | we make | error |  | 1 | G# | 103.83 Hz | 9.63 ms | 572.72 us
max period | 2.05 ms | 65.54 ms | 4.1 ms | 2.05 ms |  |  |  |  | 1 | A | 110.00 Hz | 9.09 ms | 540.57 us
 |  |  |  |  |  |  |  |  | 1 | A# | 116.54 Hz | 8.58 ms | 510.23 us
 |  |  |  |  |  |  |  |  | 1 | B | 123.47 Hz | 8.1 ms | 481.6 us
 |  |  |  |  |  |  |  |  | 2 | C | 130.81 Hz | 7.64 ms | 454.57 us
38Khz |  |  |  |  |  |  |  |  | 2 | C# | 138.59 Hz | 7.22 ms | 429.05 us
26.32 us |  |  |  |  |  |  |  |  | 2 | D | 146.83 Hz | 6.81 ms | 404.97 us
 |  |  |  |  |  |  |  |  | 2 | D# | 155.56 Hz | 6.43 ms | 382.24 us | 156.0134262615 | 155.1148550474
 |  |  |  |  |  |  |  |  | 2 | E | 164.81 Hz | 6.07 ms | 360.79 us
37.9939209726 |  |  |  |  |  |  |  |  | 2 | F | 174.61 Hz | 5.73 ms | 340.54 us
22.7963525836 |  |  |  |  |  |  |  |  | 2 | F# | 185.00 Hz | 5.41 ms | 321.43 us
7.5987841945 |  |  |  |  |  |  |  |  | 2 | G | 196.00 Hz | 5.1 ms | 303.39 us
 |  |  |  |  | min |  |  |  | 2 | G# | 207.65 Hz | 4.82 ms | 286.36 us
 |  |  |  |  |  |  |  |  | 2 | A | 220.00 Hz | 4.55 ms | 270.29 us
 |  | error in cents for making the following notes |  |  |  |  |  |  | 2 | A# | 233.08 Hz | 4.29 ms | 255.12 us
 |  |  |  |  |  |  |  |  | 2 | B | 246.94 Hz | 4.05 ms | 240.8 us
 |  | 0.12 | -0.79 | -0.79 | 0.79 | 3808000 | 14256.4329714281 | 6.47 |  | C | 261.63 Hz | 3.82 ms | 227.28 us
 |  | -0.13 | 3.71 | -0.13 | 0.13 | 3616000 | -8270.3364359117 | -3.96 |  | C# | 277.18 Hz | 3.61 ms | 214.53 us
 |  | 0.12 | -1.40 | -1.40 | 1.40 | 3392000 | 13243.3565379111 | 6.75 |  | D | 293.66 Hz | 3.41 ms | 202.49 us |  |  |  |  |  | 8.3333333333
 |  | 0.07 | -1.01 | -1.01 | 1.01 | 3200000 | 14121.7326661237 | 7.62 |  | D# | 311.13 Hz | 3.21 ms | 191.12 us
 |  | -0.16 | -3.58 | 0.99 | 0.99 | 3040000 | -6273.0587044689 | -3.58 |  | E | 329.63 Hz | 3.03 ms | 180.39 us
 |  | 0.28 | -0.33 | -0.33 | 0.33 | 2848000 | 15456.931579256 | 9.37 |  | F | 349.23 Hz | 2.86 ms | 170.27 us
 |  | -0.16 | -0.80 | -0.80 | 0.80 | 2688000 | 14743.4431880014 | 9.47 |  | F# | 369.99 Hz | 2.7 ms | 160.71 us
 |  | 0.03 | 4.79 | -0.64 | 0.64 | 2560000 | -8949.8902059719 | -6.06 |  | G | 392.00 Hz | 2.55 ms | 151.69 us
 |  | -0.09 | 5.67 | -0.09 | 0.09 | 2400000 | 7870.668998397 | 5.67 |  | G# | 415.30 Hz | 2.41 ms | 143.18 us
 |  | -0.21 | 0.55 | 0.55 | 0.55 | 2272000 | 727.2727272715 | 0.55 |  | A | 440.00 Hz | 2.27 ms | 135.14 us
 |  | 0.14 | 0.94 | 0.94 | 0.94 | 2144000 | 1168.8924583932 | 0.94 |  | A# | 466.16 Hz | 2.15 ms | 127.56 us
 |  | -0.20 | -6.17 | 0.66 | 0.66 | 2016000 | 8769.8139553154 | 7.51 |  | B | 493.88 Hz | 2.02 ms | 120.4 us |  | 496.0317460317
 |  | 0.12 | 6.47 | -0.79 | 0.79 |  |  |  |  | C | 523.25 Hz | 1.91 ms | 113.64 us |  |  |  |  |  |  |  | 16000000
 |  | -0.13 | -3.96 | 3.71 | 3.71 |  |  |  |  | C# | 554.37 Hz | 1.8 ms | 107.26 us
 |  | -0.38 | 6.75 | -1.40 | 1.40 |  |  |  |  | D | 587.33 Hz | 1.7 ms | 101.24 us
 |  | 0.07 | 7.62 | -1.01 | 1.01 |  |  |  |  | D# | 622.25 Hz | 1.61 ms | 95.56 us
 |  | -0.16 | -3.58 | -3.58 | 3.58 |  |  |  |  | E | 659.26 Hz | 1.52 ms | 90.2 us
 |  | -0.33 | 9.37 | -0.33 | 0.33 |  |  |  |  | F | 698.46 Hz | 1.43 ms | 85.14 us
 |  | 0.48 | 9.47 | -0.80 | 0.80 |  |  |  |  | F# | 739.99 Hz | 1.35 ms | 80.36 us
 |  | -0.64 | -6.06 | 4.79 | 4.79 |  |  |  |  | G | 783.99 Hz | 1.28 ms | 75.85 us
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
OCRnx | freq
100 | 79207.9207920792
200 | 39800.9950248756
210 | 37914.691943128 | 0.000026375
211 | 37735.8490566038 | 37.9146919431
212 | 37558.6854460094
213 | 37383.1775700935
215 | 37037.037037037
209 | 38095.2380952381
208 | 38277.5119617225
 | 8000000
 | 8000000
 | 8000000
 | 8000000

Sheet: Sheet3
 |  | Testing which prescale is best at which frequency
 |  | Different prescale values:
 |  | bits | 8 | 8 | 8 | 8 | 8
 |  | clock | 16. Mhz | 16. Mhz | 16. Mhz | 16. Mhz | 16. Mhz
 |  | prescale | 1024 | 256 | 128 | 64 | 32
 |  | freq_scaled | 15.63 Khz | 62.5 Khz | 125. Khz | 250. Khz | 500. Khz
 |  | max frequency | 7.81 Khz | 31.25 Khz | 62.5 Khz | 125. Khz | 250. Khz
 |  | min freq | 30.52 Hz | 122.07 Hz | 244.14 Hz | 488.28 Hz | 976.56 Hz
 |  | min period/incriment | 128. us | 32. us | 16. us | 8. us | 4. us
 |  | max period | 32.77 ms | 8.19 ms | 4.1 ms | 2.05 ms | 1.02 ms
Note | Freq | wavelength | -------------------------------------Error in cents--------------------------------------------
A | 55.00 Hz | 18.18 ms | 0.55 | 0.55 | 0.55 | -0.21 | 0.17 | 142 | 568 | 1,136 | 2,273 | 4,545 | #DIV/0! | 55
A# | 58.27 Hz | 17.16 ms | 0.94 | 0.94 | -0.67 | 0.14 | 0.14 | 134 | 536 | 1,073 | 2,145 | 4,290 | #DIV/0! | 58
B | 61.74 Hz | 16.2 ms | -6.17 | 0.66 | 0.66 | -0.20 | -0.20 | 127 | 506 | 1,012 | 2,025 | 4,050 | #DIV/0! | 62
C | 65.41 Hz | 15.29 ms | 6.47 | -0.79 | -0.79 | 0.12 | 0.12 | 119 | 478 | 956 | 1,911 | 3,822 | #DIV/0! | 65
C# | 69.30 Hz | 14.43 ms | -3.96 | -0.13 | -0.13 | -0.13 | -0.13 | 113 | 451 | 902 | 1,804 | 3,608 | #DIV/0! | 69
D | 73.42 Hz | 13.62 ms | 6.75 | -1.40 | 0.63 | -0.38 | 0.12 | 106 | 426 | 851 | 1,703 | 3,405 | #DIV/0! | 73
D# | 77.78 Hz | 12.86 ms | 7.62 | -1.01 | -1.01 | 0.07 | 0.07 | 100 | 402 | 804 | 1,607 | 3,214 | #DIV/0! | 78
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
F# | 2959.96 Hz | 337.84 us | -221.69 | -71.06 | 9.47 | 9.47 | 9.47
G | 3135.96 Hz | 318.88 us | 380.22 | -6.06 | -6.06 | -6.06 | -6.06
G# | 3322.44 Hz | 300.98 us | 280.23 | 76.33 | -17.26 | -17.26 | 5.67
A | 3520.00 Hz | 284.09 us | 180.24 | -23.66 | -23.66 | -23.66 | 0.55
A#
B
C
C#
D
D#
E

Sheet: Sheet4
board size
x | 3.22
y | 2.66
 |  | panelizing:
 |  | 3.22 | 6.44 | 9.66 | 12.88 | 16.1
 |  | 1 | 2 | 3 | 4 | 5
2.66 | 1 | 8.5652 | 17.1304 | 25.6956 | 34.2608 | 42.826
5.32 | 2 | 17.1304 | 34.2608 | 51.3912 | 68.5216 | 85.652
7.98 | 3 | 25.6956 | 51.3912 | 77.0868 | 102.7824 | 128.478 | 7.5187969925
10.64 | 4 | 34.2608 | 68.5216 | 102.7824 | 137.0432 | 171.304
13.3 | 5 | 42.826 | 85.652 | 128.478 | 171.304 | 214.13
 |  | 1 | 2 | 3 | 4 | 5
 | 1 | 1.21 | 2.42 | 3.63 | 4.84 | 42.826
 | 2 | 0.61 | 1.21 | 1.82 | 2.42 | 85.652
 | 3 | 0.40 | 0.81 | 1.21 | 1.61 | 128.478
 | 4 | 0.30 | 0.61 | 0.91 | 1.21 | 171.304
 | 5 | 42.826 | 85.652 | 128.478 | 171.304 | 214.13
