HackerScouts/hackerling-circuit/pouch/hackerling-pouch_P3.dxf

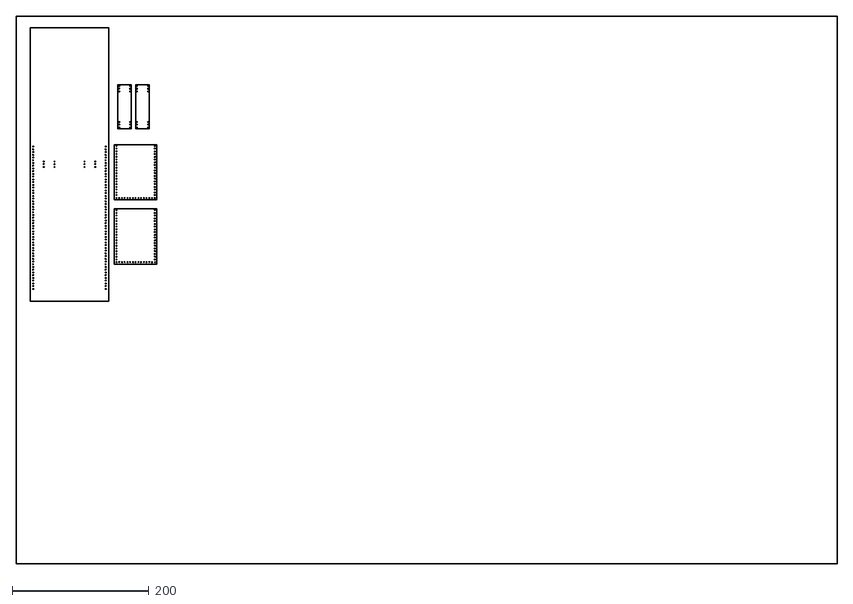
[picture p1: CAD file, 2013-02-26]
pouch/hackerling-pouch_P3.dxf
1200.0 x 800.0
