HackerScouts/hackerling-circuit/circuit/hackerling_b.brd

## EAGLE design circuit/hackerling_b.brd (2013-04-25)

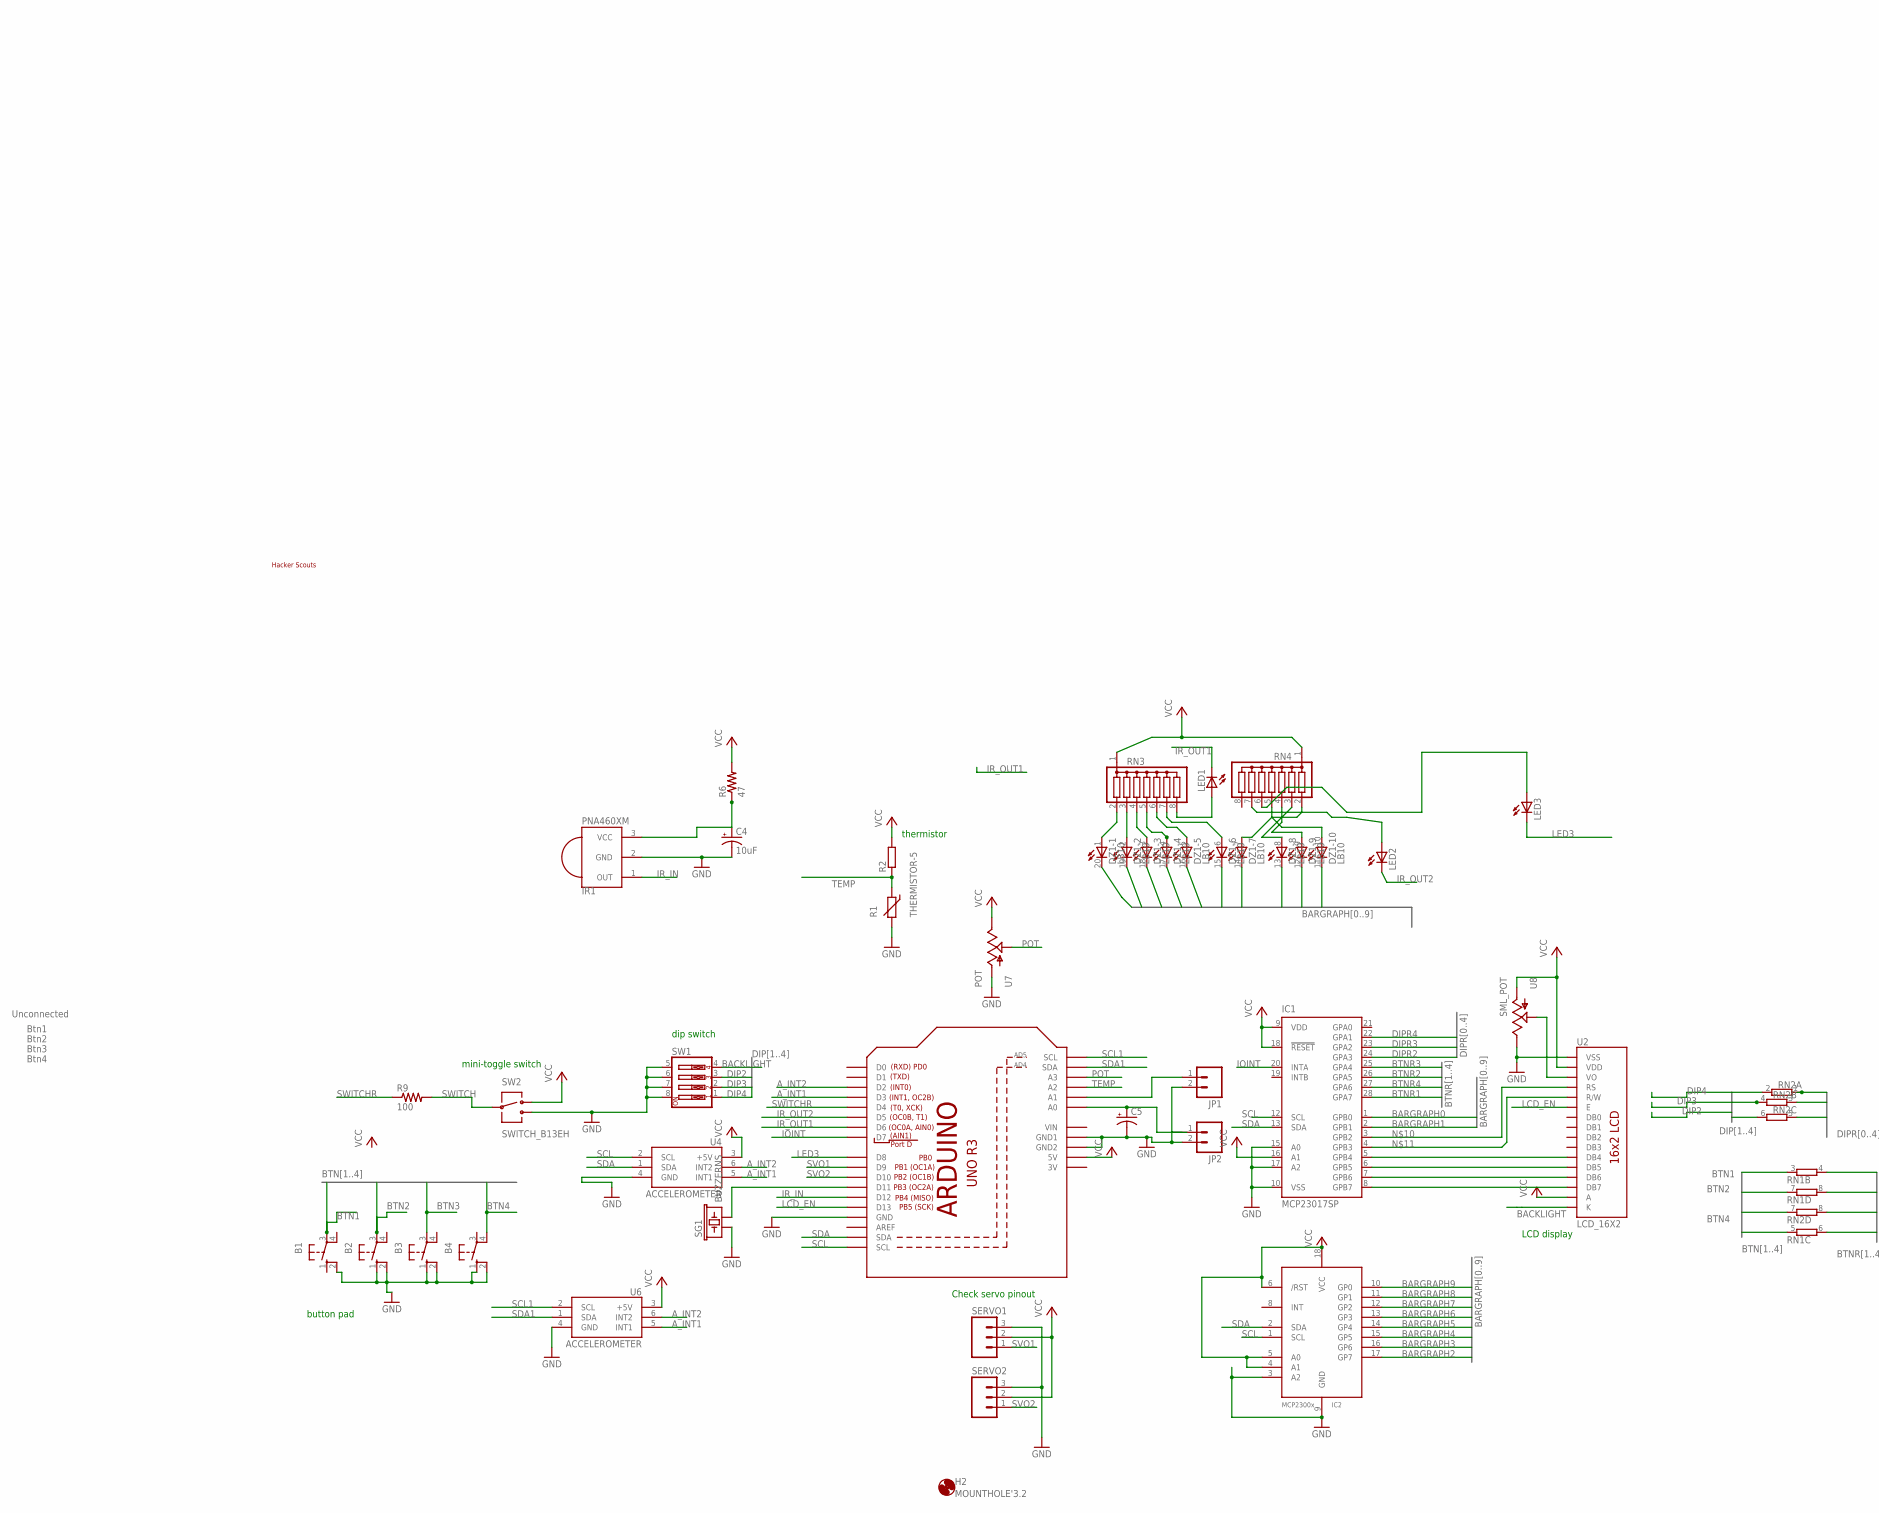
[picture p2: schematic hackerling_b.sch, part in row 1, column 1]

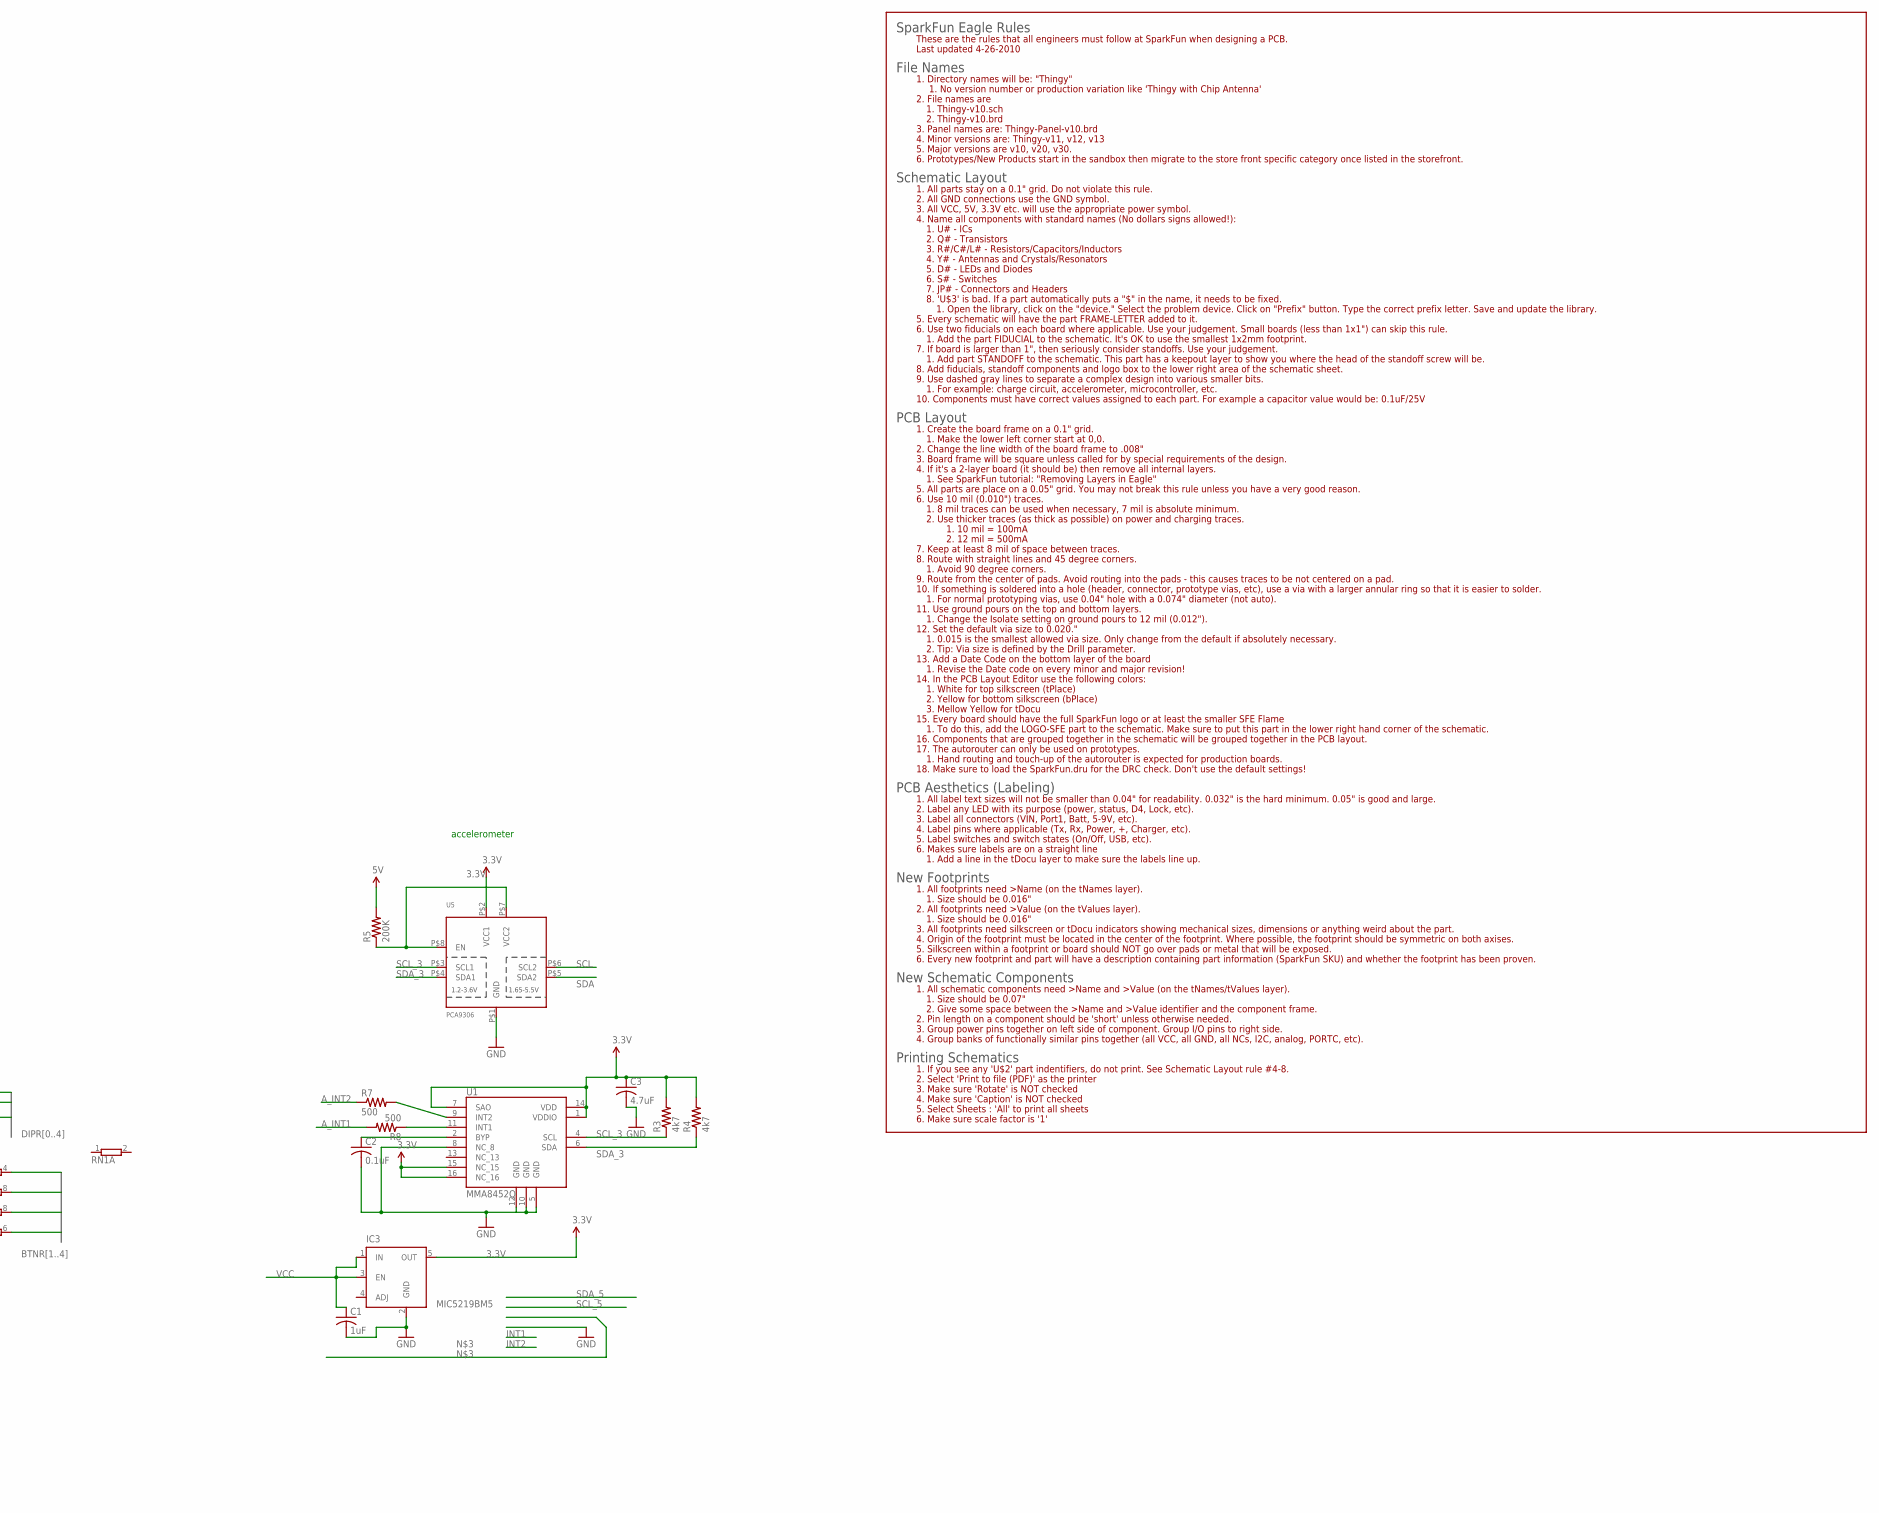
[picture p3: schematic hackerling_b.sch, part in row 1, column 2]

Parts:
B1, B2, B3, B4: SWITCH_BCF-4000; SWITCH_B3F-4000
C1: 1uF; C0603K
C2: 0.1uF; C0603K
C3: 4.7uF; C0603K
C4: 10uF; CAP_050X075
C5: CPOL-USE5-4; E5-4
DZ1: LB10
H2: MOUNTHOLE'3.2; HOLE_3.2
IC1: MCP23017SP; DIL28-3
IC2: MCP2300X/P; DIL18
IC3: MIC5219BM5; SOT23-5
IR1: PNA460XM
JP1, JP2: M02LOCK; 1X02_LOCK
LED1, LED2, LED3: LED5MM
R1: THERMISTOR-5; R-5
R2: R-EU_0204/7; 0204/7
R3, R4: 4k7; 0603-RES
R5: 200K; 0603-RES
R6: 47; 0204/7
R7, R8: 500; 0603-RES
R9: 100; 0204/7
RN1, RN2: E4R; SIL8
RN3, RN4: G07R; SIL8
SERVO1, SERVO2: M03LOCK; 1X03_LOCK
SG1: BUZZERNS; BUZZER-12MM-NS
SW1: SW_DIP-4; EDG-04
SW2: SWITCH_B13EH
U1: MMA8452Q; QFN-16(5X3)
U2: LCD_16X2
U3: ARDUINOR3-BPLACE
U4, U6: ACCELEROMETER
U5: PCA9306; VSSOP-8
U7: POT; ALS_POT
U8: SML_POT
U$2: HS-LOGOSMALL; HS-LOGO-SM

Connections:
3.3V: C3.1, IC3.5 (OUT), R3.2, R4.2, U1.1 (VDDIO), U1.7 (SAO), U1.14 (VDD), U1.15 (NC_15), U1.16 (NC_16), U5.P$2 (VCC1)
3V: U3.3V
A_INT1: R8.2, U3.D3, U4.5 (INT1), U6.5 (INT1)
A_INT2: R7.1, U3.D2, U4.6 (INT2), U6.6 (INT2)
BACKLIGHT: SW1.4, U2.16 (K)
BARGRAPH0: DZ1.20 (C), IC1.1 (GPB0)
BARGRAPH1: DZ1.19 (C), IC1.2 (GPB1)
BARGRAPH2: DZ1.18 (C), IC2.17 (GP7)
BARGRAPH3: DZ1.17 (C), IC2.16 (GP6)
BARGRAPH4: DZ1.16 (C), IC2.15 (GP5)
BARGRAPH5: DZ1.15 (C), IC2.14 (GP4)
BARGRAPH6: DZ1.14 (C), IC2.13 (GP3)
BARGRAPH7: DZ1.13 (C), IC2.12 (GP2)
BARGRAPH8: DZ1.12 (C), IC2.11 (GP1)
BARGRAPH9: DZ1.11 (C), IC2.10 (GP0)
BTN1: B1.3, RN1.3 (1)
BTN2: B2.3, RN1.7 (1)
BTN3: B3.3, RN2.7 (1)
BTN4: B4.4 (P1), RN1.5 (1)
BTNR1: IC1.28 (GPA7), RN1.4 (2)
BTNR2: IC1.26 (GPA5), RN1.8 (2)
BTNR3: IC1.25 (GPA4), RN2.8 (2)
BTNR4: IC1.27 (GPA6), RN1.6 (2)
DIP2: RN2.6 (2), SW1.3
DIP3: RN2.4 (2), SW1.2
DIP4: RN2.2, SW1.1
DIPR2: IC1.24 (GPA3), RN2.5 (1)
DIPR3: IC1.23 (GPA2), RN2.3 (1)
DIPR4: IC1.22 (GPA1), RN2.1
GND: B1.2 (S1), B2.1 (S), B2.2 (S1), B3.1 (S), B3.2 (S1), B4.1 (S), B4.2 (S1), C1.2, C2.2, C3.2, C4.2 (-), C5.-, IC1.10 (VSS), IC1.15 (A0), IC1.17 (A2), IC2.3 (A2), IC2.9 (GND), IC3.2 (GND), IR1.2 (GND), JP1.2, JP2.2, R1.2, SERVO1.3, SERVO2.3, SG1.+ (1), SW1.5, SW1.6, SW1.7, SW1.8, SW2.3, U1.5 (GND), U1.8 (NC_8), U1.10 (GND), U1.12 (GND), U2.1 (VSS), U2.B1 (VSS), U3.GND, U3.GND1, U3.GND2, U4.4 (GND), U5.P$1 (GND), U6.4 (GND), U7.P$1 (A), U8.E
IOINT: IC1.20 (INTA), U3.D7
IR_IN: IR1.1 (OUT), U3.D12
IR_OUT1: LED1.K (C), U3.D6
IR_OUT2: LED2.K (C), U3.D5
LCD_EN: U2.6 (E), U3.D13
LED3: LED3.K (C), U3.D8
unnamed: IC1.8 (GPB7), U2.14 (DB7)
unnamed: IC1.7 (GPB6), U2.13 (DB6), U2.B13 (DB6)
unnamed: IC1.6 (GPB5), U2.12 (DB5), U2.B12 (DB5)
unnamed: IC1.5 (GPB4), U2.11 (DB4)
unnamed: R5.1, U5.P$7 (VCC2), U5.P$8 (EN)
unnamed: R7.2, U1.9 (INT2)
unnamed: R8.1, U1.11 (INT1)
unnamed: DZ1.2 (A), RN3.3
unnamed: DZ1.3 (A), RN3.4
unnamed: IC1.3 (GPB2), U2.4 (RS)
unnamed: IC1.4 (GPB3), U2.5 (R/W)
unnamed: LED2.A, RN4.7
unnamed: U2.3 (VO), U8.S
unnamed: SG1.- (2), U3.D11
unnamed: DZ1.7 (A), RN4.2
unnamed: DZ1.6 (A), RN3.7
unnamed: DZ1.1 (A), RN3.2
unnamed: C4.1 (+), IR1.3 (VCC), R6.1
unnamed: LED3.A, RN4.6
unnamed: DZ1.4 (A), RN3.5
unnamed: DZ1.5 (A), RN3.6
unnamed: JP1.1, U3.A1
unnamed: C2.1, U1.2 (BYP)
unnamed: C5.+, JP2.1, U3.A0
unnamed: DZ1.8 (A), RN4.3
unnamed: DZ1.9 (A), RN4.4
unnamed: DZ1.10 (A), RN4.5
unnamed: LED1.A, RN3.8
POT: U3.A3, U7.P$2 (S)
SCL: IC1.12 (SCL), IC2.1 (SCL), U3.SCL, U4.2 (SCL), U5.P$6 (SCL2)
SCL1: U3.A5 (SCL), U6.2 (SCL)
SCL_3: R3.1, U1.4 (SCL), U5.P$3 (SCL1)
SDA: IC1.13 (SDA), IC2.2 (SDA), U3.SDA, U4.1 (SDA), U5.P$5 (SDA2)
SDA1: U3.A4 (SDA), U6.1 (SDA)
SDA_3: R4.1, U1.6 (SDA), U5.P$4 (SDA1)
SVO1: SERVO1.1, U3.D9
SVO2: SERVO2.1, U3.D10
SWITCH: R9.2, SW2.2
SWITCHR: R9.1, U3.D4
TEMP: R1.1, R2.1, U3.A2
VCC: C1.1, IC1.9 (VDD), IC1.16 (A1), IC1.18 (!RESET), IC2.4 (A1), IC2.5 (A0), IC2.6 (/RST), IC2.18 (VCC), IC3.1 (IN), IC3.3 (EN), R2.2, R5.2, R6.2, RN3.1, RN4.1, SERVO1.2, SERVO2.2, SW2.1, U2.2 (VDD), U2.15 (A), U2.B2 (VDD), U3.5V, U4.3 (+5V), U6.3 (+5V), U7.P$3 (E), U8.A
VIN: U3.VIN

Notes on the sheet:
mini-toggle switch
thermistor
dip switch
LCD display
button pad
accelerometer
Check servo pinout
Unconnected
Btn1
Btn2
Btn3
Btn4

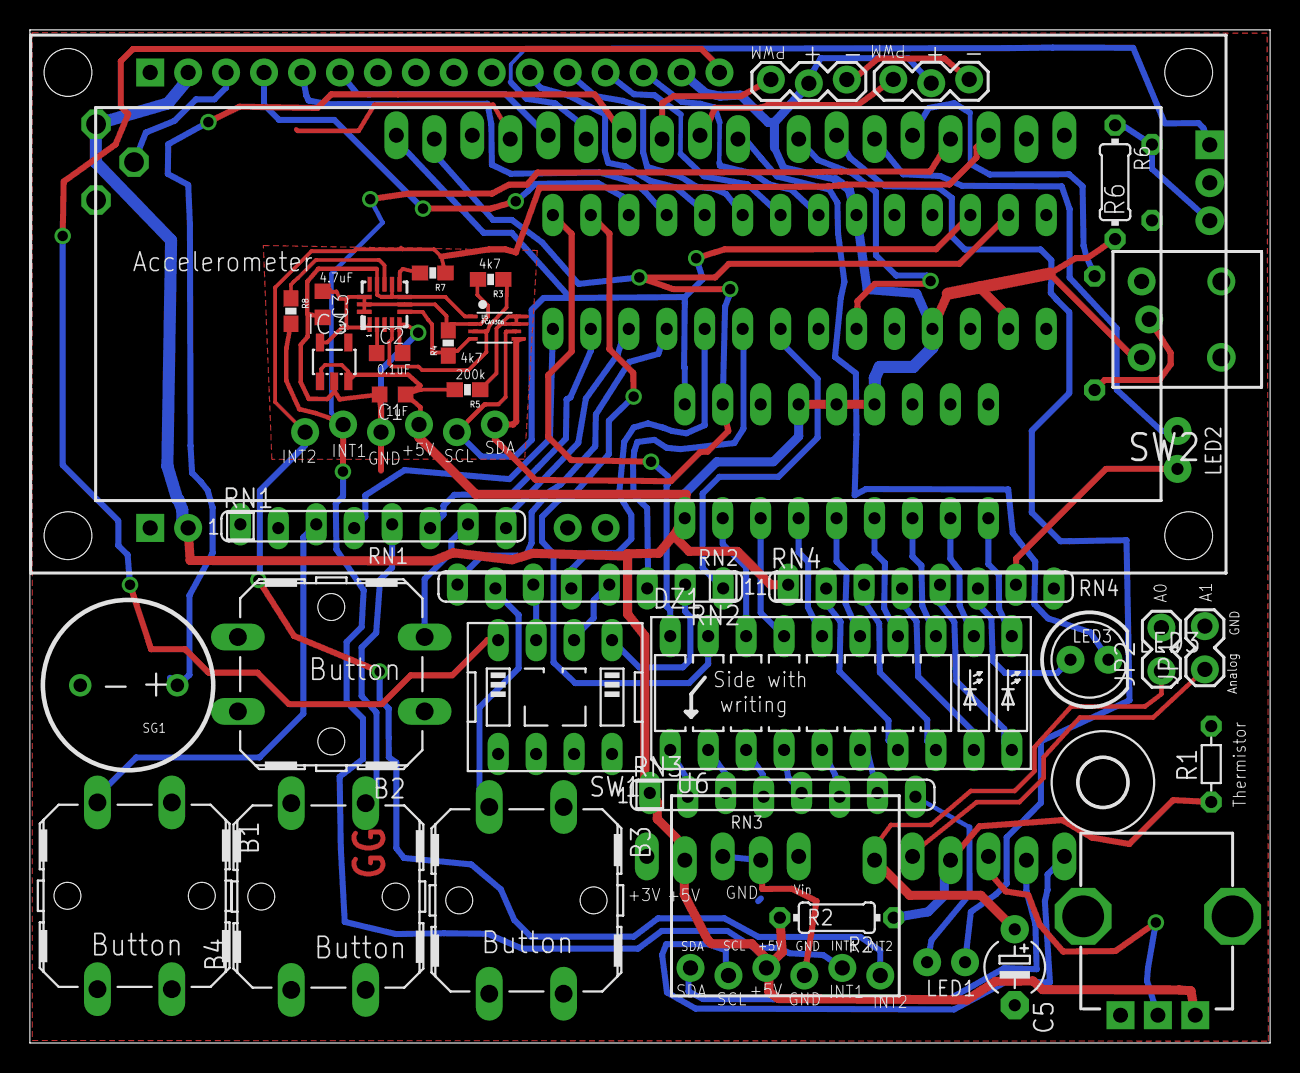
[picture p4: board hackerling_b.brd from above]

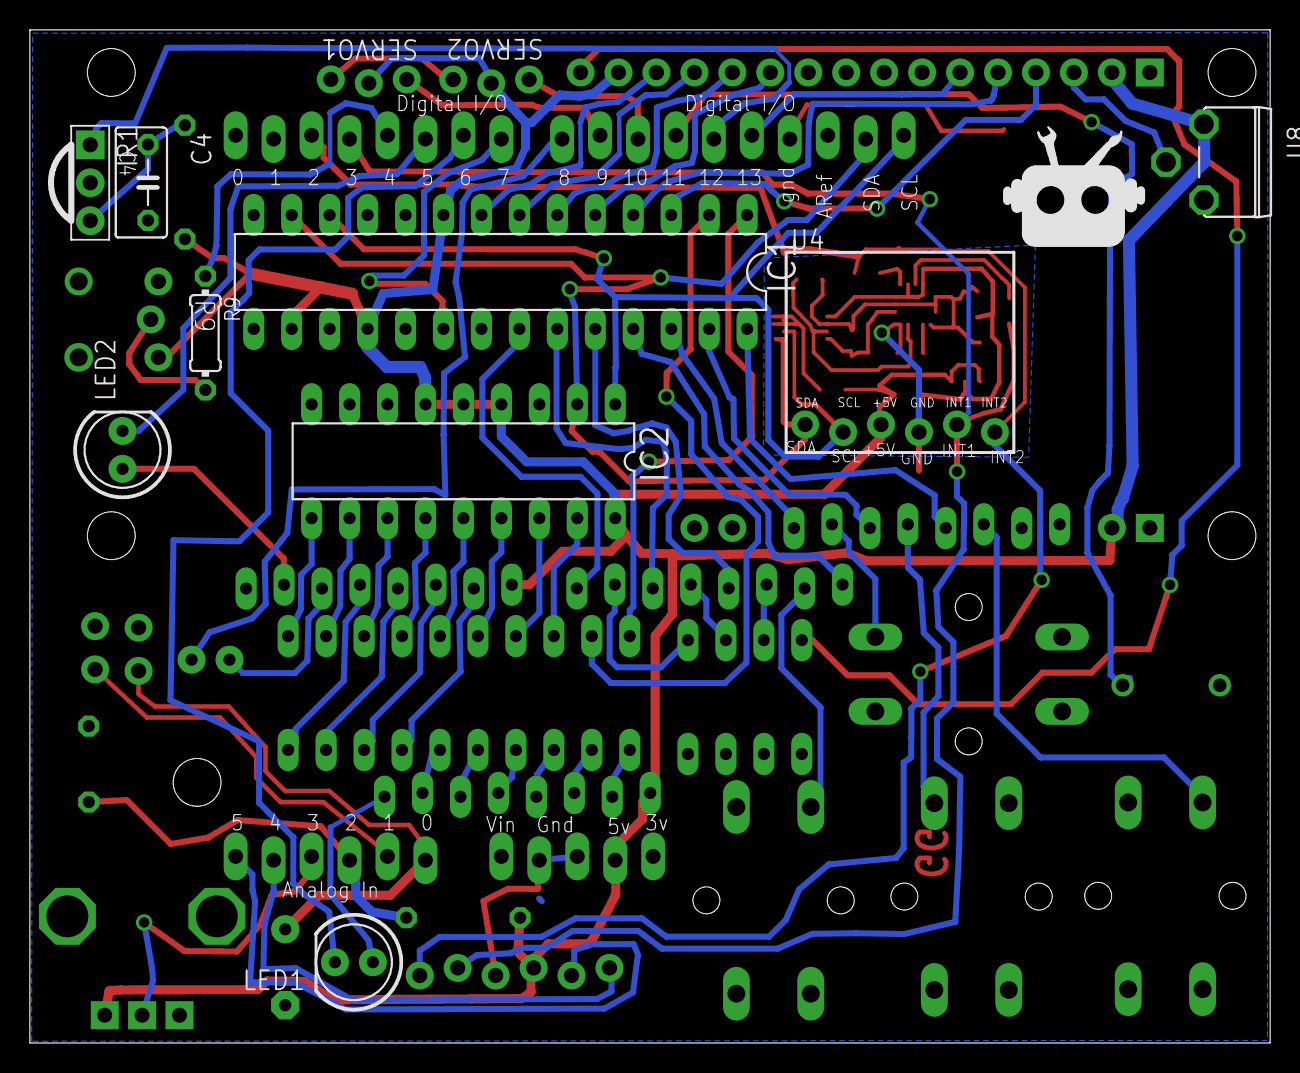
[picture p5: board hackerling_b.brd from below]

Board: 2 copper layers, 83.0 x 67.8 mm, 47 parts (10 on the bottom side), 76 nets.
