HackerScouts/hackerling-circuit/circuit/accelerometer.brd

## EAGLE design circuit/accelerometer.brd (2012-12-12)

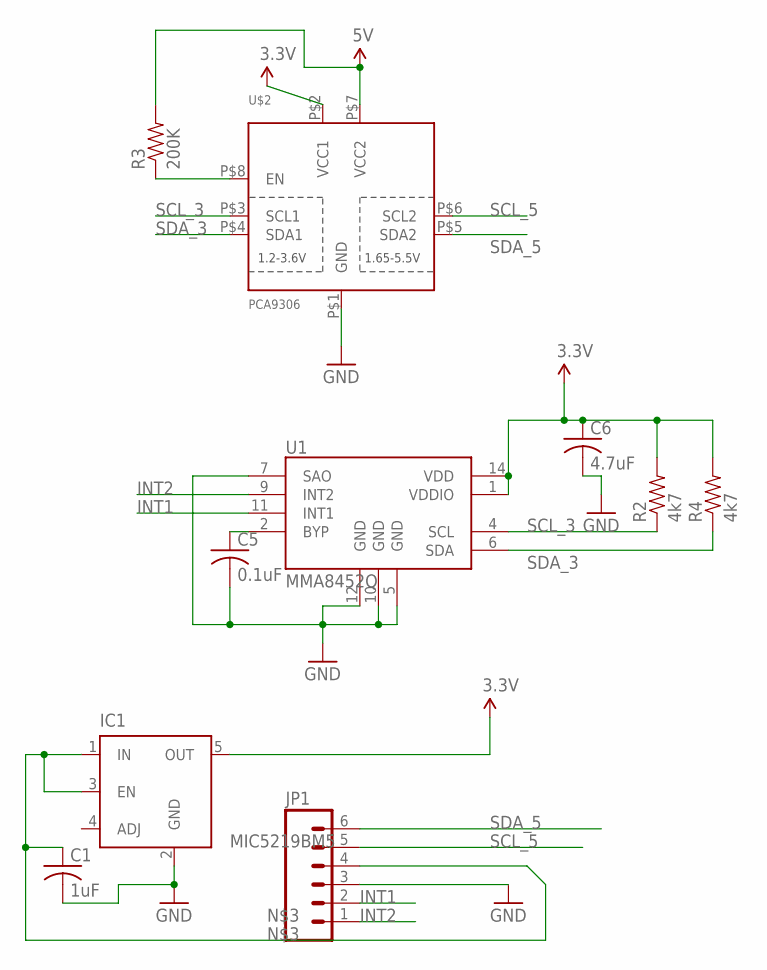
[picture p6: schematic accelerometer.sch]

Parts:
C1: 1uF; C0603K
C5: 0.1uF; C0603K
C6: 4.7uF; C0603K
IC1: MIC5219BM5; SOT23-5
JP1: M06LOCK; 1X06_LOCK
R2, R4: 4k7; 0603-RES
R3: 200K; 0603-RES
U1: MMA8452Q; QFN-16(5X3)
U$2: PCA9306; VSSOP-8

Connections:
3.3V: C6.1, IC1.5 (OUT), R2.2, R4.2, U1.1 (VDDIO), U1.14 (VDD), U$2.P$2 (VCC1)
5V: R3.2, U$2.P$7 (VCC2)
GND: C1.2, C5.2, C6.2, IC1.2 (GND), JP1.3, U1.5 (GND), U1.7 (SAO), U1.10 (GND), U1.12 (GND), U$2.P$1 (GND)
INT1: JP1.2, U1.11 (INT1)
INT2: JP1.1, U1.9 (INT2)
unnamed: C5.1, U1.2 (BYP)
unnamed: C1.1, IC1.1 (IN), IC1.3 (EN), JP1.4
unnamed: R3.1, U$2.P$8 (EN)
SCL_3: R2.1, U1.4 (SCL), U$2.P$3 (SCL1)
SCL_5: JP1.5, U$2.P$6 (SCL2)
SDA_3: R4.1, U1.6 (SDA), U$2.P$4 (SDA1)
SDA_5: JP1.6, U$2.P$5 (SDA2)

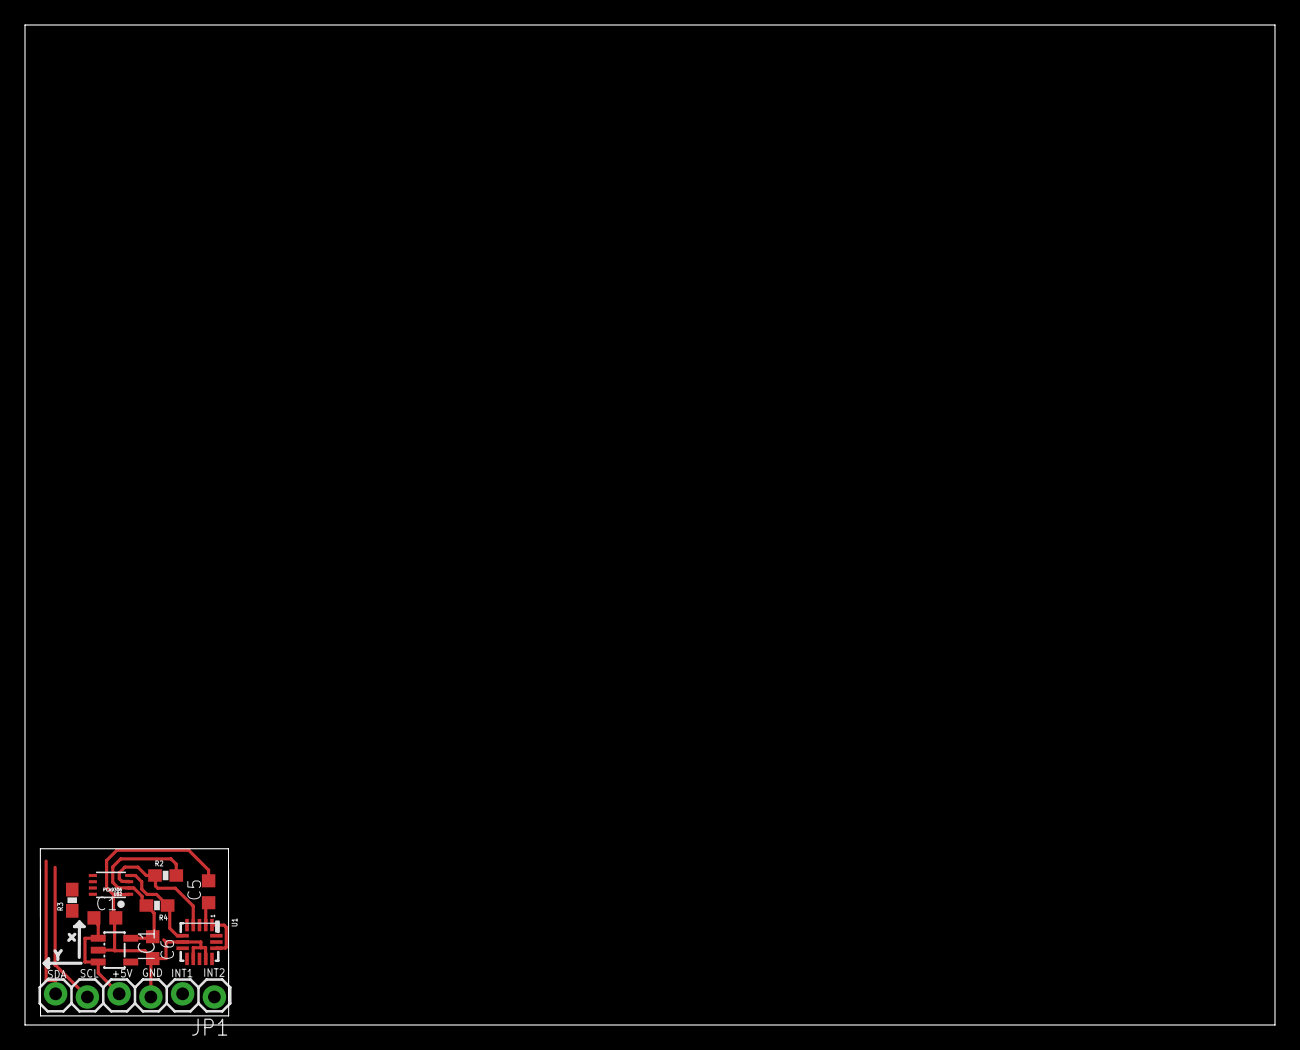
[picture p7: board accelerometer.brd from above]

Board: 2 copper layers, 100.0 x 80.0 mm, 10 parts (0 on the bottom side), 12 nets.
