HackerScouts/hackerling-circuit/(commit log)

2012-11-28 initial files and structure
    [hackerling.brd, hackerling.sch]
2012-11-28 adding BOM
    [Hackerling_Circuit_BOM.xls]
2012-11-28 adding arduino UNO eagle files
    [arduino_Uno_Rev3-02-TH.brd, arduino_Uno_Rev3-02-TH.sch]
2012-11-28 adding arduino UNO schematic pdf
2012-11-30 adding accelerometer, as a library item, and arranged the circuit layout in a possibly optimal pattern
    [accelerometer.brd, accelerometer.sch]
2012-12-01 arranging the hackerling circuit, added accelerometer layout
    [hackerling.brd, hackerling.sch]
2012-12-01 still arranging, about to rotate and shift parts
    [hackerling.brd, hackerling.sch]
2012-12-05 circuit state as of barebones order BOM is out of date still.... Just copied hackerling_a back to hackerling.
    [hackerling.brd, hackerling.sch]
2012-12-05 adding instruction steps
    [hackerling.brd, hackerling.sch]
2012-12-07 fixing a few bugs, updating bom
    [Hackerling_Circuit_BOM.xls, hackerling.brd, hackerling.sch]
2012-12-10 adding lots of documentation in the reference layer
    [hackerling.brd]
2012-12-12 changing accelerometer, adding hooked up address pins
    [Hackerling_Circuit_BOM.xls, accelerometer.brd, accelerometer.sch, hackerling.brd, hackerling.sch]
2012-12-23 adding adafruit libs to software folder
    [hackerling.brd, hackerling.sch]
2012-12-24 re-arranged directories to that they work with arduino structure. CylonBarGraph compiles and makes LEDs blink.
2012-12-25 old changes to circuit adding design docs adding libraries for new chips
    [frequency_calcs.ods, hackerling.brd, hackerling.sch]
2012-12-27 tested LCD, works added library to test with - library needs cleaning made some minor changes to the board, removed rx, tx connections
    [hackerling.brd, hackerling.sch]
2012-12-27 tested MCP23008, works changed buttons to connect to MCP23017 rerouted stuff
    [hackerling.brd, hackerling.sch]
2012-12-29 circuit state upon submit of version 1.0
    [frequency_calcs.ods, hackerling.brd, hackerling.sch, panel.cfg]
2012-12-31 resubmitting circuit version 1.1 was held for drill overlap modified board slightly, mostly in soldermask to improve readability the ir reciever shifted, and moved a few vias.
    [hackerling.brd, hackerling.sch, panel.cfg]
2013-01-07 documenting updated values in eagle files filled out BOM writing installation instructions
    [Hackerling_Circuit_BOM.xls, hackerling.brd, hackerling.sch]
2013-01-13 adding examples for assembly steps
2013-01-13 staging the hackerling circuit class
    [Hackerling_Circuit_BOM.xls]
2013-02-26 added pouch and enclosure. they should be updated soon.
    [hackerling-pouch_P3.dxf]
2013-04-10 power change to accelerometer section
    [hackerling.brd, hackerling.sch]
2013-04-10 removing optional components
    [hackerling.brd, hackerling.sch]
2013-04-10 updating design files
    [Hackerling_Circuit_BOM.xls, frequency_calcs.ods]
2013-04-11 adding resistors to interrupt
    [hackerling.brd, hackerling.sch]
2013-04-15 before moving pins around
    [hackerling.sch]
2013-04-15 added updated board hackerling_b. It contains the changes that were needed from v1.1 to v1.2 the board will be merged back into the main board after approval.
    [hackerling_b.brd, hackerling_b.sch]
2013-04-18 made silkscreen and some cosmetic changes
    [hackerling_b.brd, hackerling_b.sch]
2013-04-25 changes made for version 1.2. ordered boards.
    [hackerling_b.brd, hackerling_b.sch]
2014-03-02 updating BOM
    [Hackerling_Circuit_BOM.xls]
